Eddym06/AutoNex/simulator/README.md

# Simulador WRO Future Engineers

> El modelo predeterminado se cambió a bicicleta para el nuevo chasis Ackermann.
> Las medidas ficticias elegidas se detallan en [PERFIL_PROVISIONAL.md](PERFIL_PROVISIONAL.md).
> La geometría y el encoder son provisionales, y el parqueo es experimental;
> las cifras y pruebas históricas descritas abajo corresponden al chasis anterior.
> Tras cualquier cambio en el C hay que reconstruir el WASM: la generación del
> HTML comprueba un manifiesto de hashes y rechaza uno ausente o antiguo, y
> `core.js` aborta si la ABI del binario no es la esperada.
> El binario incluido está reconstruido y el manifiesto verifica las fuentes.
> La entrada al cajón y la misión completa Ackermann siguen sin medición real.

Simula una ronda completa de la pista WRO 2024 con sensores realistas y **ejecuta el C real del firmware** (visión del S3 no incluida: la cámara virtual produce imágenes RGB565 que pasan por el mismo `vision.c`; el planificador y el controlador del P4 corren compilados a WebAssembly). No hay reimplementación en JavaScript de la lógica, y el robot **no ve la verdad del mundo**: solo lo que miden sus sensores simulados.

## Uso

```powershell
python simulator\build_simulator.py      # genera simulator\build\simulador.html (un solo archivo)
```

Abre `simulador.html` en el navegador después de reconstruir el WASM. La salida
del cajón y el parqueo Ackermann son experimentales y aún no están validados
con sensores ni mediante rondas completas. Controles:
**Simular / Reiniciar**, velocidad de reproducción, pista, sentido, semilla,
plano JSON, capas visibles, lados de paso y parámetros de controlador y sensores.

> La interfaz se probó con un DOM simulado (`test_ui_smoke.js`), **no visualmente en un navegador**. Si algo se ve mal, es lo primero que conviene revisar.

## Qué modela

- **Pista** (reglamento 2026): campo de 3 × 3 m, carril de 100 cm, paredes de 10 cm, bloques 5 × 5 × 10 cm en asientos de 5 × 5 cm (2 × 3 por recta, modelo `seatModel` parametrizable), **8 líneas naranja/azul de 2 cm en V** (una pareja por esquina, a 30° de los muros) y el cajón de parqueo (20 cm de ancho, 1,5 × el largo del robot, topes magenta de 20 × 2 × 10 cm) en la sección de arranque.
- **LiDAR D6**: barrido continuo a 10 Hz con 400 rayos, ruido, pérdida de retornos, zona ciega y máscara del propio chasis. El robot se mueve durante el barrido (el firmware lo corrige con deskew).
- **Cámara**: proyección por trazado de rayos con cámara inclinada, ruido, viñeteo, nivel de luz, desenfoque, latencia y errores de bits.
- **Giroscopio**: sesgo y deriva aleatoria.
- **Encoders** (uno por rueda): ver «Encoders, pose estimada y herramientas de medida».
- **Robot**: chasis de 22 × 14 cm con **dirección Ackermann** (servo con retardo, límite de 40° por lado — 16,7 cm de radio mínimo del eje trasero — y desvío de 0,8°), motor trasero con zona muerta y ganancia de velocidad 0,94 que el controlador no conoce. El modo diferencial de 17 × 13 (`differential17`) sigue disponible para los planos y las cifras históricas: gira en el sitio y desliza por la pared. Contra un obstáculo el chasis desliza por la cara con la que roza; los bloques se empujan.
- **Juez** (2026): 1 punto por sección y por vuelta, 10 por no mover bloques, 3 por parar en la sección de arranque, 7 por arrancar en el cajón y completar una vuelta, 15 por aparcar dentro y en paralelo (la diferencia entre distancias de dos ruedas del mismo lado a la pared no supera 2 cm) o 7 si es parcial; tocar un tope termina la ronda; lado equivocado o bloque fuera de su círculo, también. Un robot que **gira en el sitio** no cuenta como parado (las maniobras de parqueo pivotan con velocidad 0). Máximo 62 puntos.

## Cajón, pose de arranque y perfil de robot

El reglamento ata el largo del cajón al del robot (1,5 ×) y la pose de arranque
centra el **cuerpo**, no el eje. Por eso la simulación ajusta los dos al chasis que
va a correr (`field.fitToRobot`): un plano que no fija `robotLength` se dibuja para
el robot simulado, y uno que sí lo fija se respeta tal cual (así el mismo JSON da
siempre la misma escena). Antes el cajón medía siempre 1,5 × 22 cm y la pose inicial
usaba el cuerpo de 22 cm: con el chasis de 17 cm el robot arrancaba con el morro
fuera del cajón y la maniobra de salida no tenía solución, así que el planificador se
quedaba parado y la ronda terminaba por `stalled`.

Un plano puede además declarar **para qué chasis se dibujó** con la clave `robot`
(`{"robot": "differential17"}`), y todos los que lo reproducen —la interfaz, el banco,
`depurar.py`, `layout.js`— corren ese perfil (`robot.js: PROFILES`) en vez del modelo
por defecto. Los dos planos de referencia del equipo son de ese chasis: reproducirlos
con el robot nuevo daba un cajón de 25,5 cm para un chasis de 22 cm y la maniobra de
salida no tenía solución. El controlador recibe además el largo real del cajón
(`park_lot_length_cm`), para no suponer que siempre mide 1,5 × su propio largo.

## Pruebas

```powershell
node simulator\tests\test_sim_basics.js     # geometría, sensores, dinámica, juez, avisos de plano
node simulator\tests\test_contrato.js       # ABI firmware↔simulación, frecuencia de cámara, cajón a medida
node simulator\tests\test_axle_encoder.js   # encoder de eje y reducción externa
node simulator\tests\test_parking_exit.js   # salida del cajón, 6 combinaciones sentido/semilla
node simulator\tests\test_parking_entry.js  # entrada al cajón: repasadas contadas y acotadas
node simulator\tests\test_ui_smoke.js       # la interfaz arranca
node simulator\tests\test_missions.js       # rondas completas (minutos)
python simulator\sequence_simulation.py     # secuencias de visión (129 comprobaciones) -> build\sequence-simulation\report.html
```

`Vision System\tools\simulate.ps1` ejecuta las pruebas en C y todas las de arriba
en orden (`-Quick` se salta las rondas completas).

Herramientas de depuración en `simulator/tests/` (`batch.js`, `scenario.js`, `inspect.js`, `planat.js`, `mapdump.js`…): ejecutan lotes de diseños aleatorios o muestran el mapa/plan en un instante dado.

## Recompilar el firmware a WebAssembly

El simulador carga `web/wro_core.wasm`, versionado en el repositorio. Si cambias el C de `LIDAR System/main`, `Vision System/main` o `shared/`, recompílalo:

```powershell
$env:WASI_SDK_PATH = "C:\ruta\wasi-sdk"   # o usa -Download para bajarlo a simulator\.toolchain
.\simulator\wasm\build.ps1                # o: Vision System\tools\simulate.ps1 -Wasm
```

`simulate.ps1` avisa si el `.wasm` es más antiguo que el C. La interfaz entre JS y C está en `wasm/core_api.c`.

## Resultados medidos

- Pista vacía, ambos sentidos: 3 vueltas, parada en el tramo de salida, 55 puntos, ~125–140 s.
- Con el chasis de 17 × 13 cm: salir del cajón, 3 vueltas y aparcar sin bloques, 62 puntos en los dos sentidos (`test_missions.js`), 24/24 secciones y sin contactos.
- Con el chasis Ackermann (volante a 40°): salir del cajón en **9,2–9,7 s**, 6 de 6 (`test_parking_exit.js`); aparcar desde la pista en 3 de 3; **misión completa de 62 puntos en 4 de 4 casos**, terminando a los 141–155 s de los 180, con 1 y con 2 letreros.
- El tiempo de las maniobras se fue en la velocidad, no en planificar: un perfil de la salida daba **21,9 s en movimiento y 0,4 s planeando**. Los arcos iban a 4 cm/s y, peor, **frenaban a ~1 cm/s en el último tramo de cada arco**, cuando el final de un arco no es una parada sino donde se encadena el siguiente. Quitado ese frenado y el tope de 4 cm/s, la salida pasó de 21–24 s a 9,2–9,7 s y la misión dejó de quedarse sin tiempo.
- 30° frente a 40°: con 40° las seis combinaciones de salida tardan 20,7–24 s; con 30° salían todas pero con un caso de 47–55 s. Más ángulo = salida más corta y más pareja.
- Banco de 100 pistas aleatorias con 7 letreros y cajón, a 23 cm/s: 99 perfectas (semillas 21–70) y 95 (semillas 71–120), sin contactos. `tests/plano_errores.json`: 62 puntos, 177 s. Estado y pendientes en `ESTADO.md` (raíz).
- Costo de un paso de simulación en el navegador con este WASM: 1,5 ms (unos 6,9 s simulados por segundo real). Ver `RENDIMIENTO.md`.

## Salir y entrar del cajón: la geometría que manda

Con la carrocería de 22 × 14 cm y el cajón de 20 × 33 cm (topes de 2 cm), el límite **no
es la pared de atrás** (con el cuerpo a 2 cm, la esquina trasera barre 8,06 cm alrededor
del eje, que está a 9 cm de la pared). El límite son **los topes de los extremos**: sólo
hay 5,5 cm de sobra por punta. Medido con el modelo de bicicleta y la maniobra "reversa
con el volante hacia el carril y luego avance al máximo":

| Volante | Reversa útil | Avance antes de tocar | Giro | ¿Sale en dos fases? |
| --- | ---: | ---: | ---: | --- |
| 30° | 4,3 cm | 9,3 cm | 32° | no: hay que hacer maniobra |
| 40° | 3,0 cm | 22,5 cm | 87° | sí |
| 45° | 2,3 cm | 22,5 cm | 101° | sí |

Con 40° la salida cabe en dos arcos, y eso es lo que hace el planificador
(`park_ackermann.c`): búsqueda A* sobre (u, w, θ) con arcos de 3,5 cm, avance y reversa,
colisión de las cuatro esquinas contra la pared y los dos topes, y re-localización en cada
barrido. Dos detalles que costaron encontrar: si la maniobra deja el chasis dentro del
margen de seguridad se reintenta **sin holgura** (si no, el planificador se niega a
planificar y el robot se queda parado el resto de la ronda), y la meta de salida exige
|θ| ≤ 10° para poder entrar al carril.

**Entrar es más caro que salir, y la asimetría está en la ejecución.** La simetría está bien
planteada — un camino libre recorrido al revés también es libre, porque son las mismas poses — y
el planificador aislado la cumple: desde la pose donde acaba la salida, la entrada cuesta **1
repasada**, igual que la salida. Por eso la entrada del controlador **arranca donde acabó la
salida** (`park_step` la recuerda al terminar `PARK_EXIT`): un crucero por el carril hasta 2 cm
más adelante y 1,5 cm más lejos de la pared (donde la maniobra cabe con una repasada, medido en
el planificador), y desde ahí **un solo plan** del A*.

Lo que quedaba era el **ejecutor**: el servo tarda ~0,2 s en invertir el volante, así que el
primer arco de cada cambio de sentido gira menos que el modelo, y los arcos medidos por distancia
se cortan 0,2–0,3 cm pronto. Sobre 15 arcos son ~3 cm y ~10° de morro; el planificador abortaba
el plan antes de enderezar y la corrección costaba una repasada más. Para la entrada simétrica los
arcos se cortan **por rumbo del giroscopio** (el giro exacto del plan), se vigila el avance a
ciegas (desvío > 6 cm o > 25° = algo pasó) y la comprobación del arco se hace con media holgura.
La salida y la demostración desde la pista se quedan con el ejecutor de siempre (la salida va
sobrada y así sigue en 8-9 s).

Medido en ronda completa (largo26, 4 casos):

| Entrada | Repasadas | Tiempo | Puntos |
| --- | --- | --- | --- |
| arrancar donde el LiDAR ve el cajón | 8, 4, 4, 3 | 12–17 s | 62 |
| simétrica desde la salida | **3, 3, 5, 6** | 13,7–17,5 s | 62 |

Todo *full* y sin contactos en los ocho casos. Probar más fuerte (sin holgura al comprobar el
arco) daba 2 repasadas en un caso pero el juez lo veía **parqueo parcial**: la media holgura es
el punto. Queda bajar el 5–6 de los casos "cw": el A* cambia de 1 a 2 repasadas con 1 cm de
diferencia en la pose de arranque (es su sensibilidad, no un error de cuenta); se mide con
`simulator/tests/parkentry.js`.

Para la entrada hay una **maniobra dedicada de tres tramos** (`park_ackermann_entry_maneuver`):
*colocarse con un arco de avance → entrar girando con un arco largo de reversa → enderezar*.
Se buscan las tres longitudes con la geometría real y solo se acepta si termina centrada y
paralela; el plan sale con **2 cambios de sentido** (medido, p. ej. `AAAA…RRRR…A`). Se
intenta en cada repaso mientras el coche siga en el carril; desde dentro del cajón manda el
A* (intentarla ahí no converge: la ronda acababa a los 180 s con parqueo parcial).

Aun así, **las repasadas ejecutadas son 4–8** (antes 7–8): las que quedan son la alineación
final dentro del cajón, donde el coche ya no puede hacer arcos largos y el A* trabaja con
arcos de 3,5 cm. La primera intentona con una S de dos arcos
(`park_ackermann_entry_s`) no cabe en este cajón: retroceder a volante lleno desde el carril
engancha la esquina trasera con el tope a los 6,5 cm.

## Depurar un plano: `tools/depurar.py`

```powershell
python simulator\tools\depurar.py plano.json                 # ronda estricta: se detiene en la primera infracción
python simulator\tools\depurar.py plano.json --indulgente    # anota todas las infracciones y sigue, para ver todos los fallos
python simulator\tools\depurar.py plano.json --permitir parqueo   # da por bueno un hallazgo ya documentado (se sigue imprimiendo)
python simulator\tools\depurar.py plano.json --json info.json --ctrl "planner.speed_cm_s 15"
```

Ejecuta el plano en **el mismo simulador** (firmware C en WebAssembly, sensores, robot, juez; con el cuadro de configuración por defecto como la interfaz, y el chasis que declare el plano) y escribe un informe: resultado, fases, y para cada hallazgo (infracciones, paradas, bucles de reversa, contactos, tramos lentos, salida/parqueo que no terminan, avisos del plano) el instante, la posición, la sección, lo que decide el firmware, los letreros reales cerca y el **mapa del planificador** en ese instante, con el comando exacto para mirarlo más (`tools/debug_trace.js snap plano.json T`). Pensado para que cualquier persona o modelo localice el problema sin leer trazas enormes. Devuelve código de salida 1 si encuentra infracciones, paradas, bucles, o una salida del cajón o un parqueo que no terminan (`--permitir <tipo>` los degrada a avisos, para un caso ya documentado).

Los **avisos del plano** (`field.checkLayout`, también visibles en la interfaz bajo el panel del juez) detectan letreros consecutivos —o la salida del cajón y un letrero— que exigen cambiar de lado más rápido de lo que cabe: es un problema del plano, no del firmware. Casos de ejemplo: `tests/plano_errores.json` (tiene dos) y `tests/plano_corregido.json` (sin avisos; ronda completa sin hallazgos, parqueo incluido).

## Reproducir un caso

Desde la interfaz, **Plano ⇄ JSON** exporta el diseño. Para ejecutarlo sin navegador y ver qué decide el robot:

```powershell
node simulator\tests\layout.js plano.json                 # ronda completa y veredicto del juez
node simulator\tests\layout.js plano.json 20 40 1         # traza del segundo 20 al 40
node simulator\tests\ctrltrace.js plano.json 10 30 1      # rumbo del giroscopio, rumbo del recorrido, paredes, esquinas
node simulator\tests\dumpat.js plano.json 26 45           # mapa local del planificador en ese instante
```

`simulator/tests/plano_atasco.json` es un caso real reportado (se quedaba yendo y viniendo): la causa era que, tras esquivar pegado a la pared, el rumbo del recorrido se reanclaba con las paredes vistas en diagonal y la esquina no se contaba. Está corregido; ver *Limitaciones físicas* abajo para lo que queda de ese plano.

## Linea de carrera

Con `race_enabled 1` (apagada por defecto) el robot calcula tras la primera vuelta una linea de carrera: el mapa la dibuja coloreada por la velocidad que pide (casilla *linea de carrera*) y el panel *Controlador* tiene una fila con su estado. `node simulator/tools/race_check.js SEMILLA ccw|cw [--cfg ..] [--trace --lap 2]` muestra cuando se construye, que letreros conoce frente a los reales, y velocidad media por vuelta. El banco de 100 pistas (`tools/bench/big.sh`) admite `WEB=carpeta` (copia congelada de `simulator/web`), `OUT=carpeta`, `FROM`/`TO` y `SIGNS`.

## Cómo es la pista y qué se ve

- **Pista**: es la del reglamento WRO Future Engineers 2024 (campo de 3 × 3 m, paredes negras de 10 cm, carril de 100 cm con el cuadrado interior de 100 × 100 cm). Las medidas salen del reglamento oficial; las posiciones de los letreros no (ver abajo).
- **Líneas naranja y azul**: son las líneas del suelo de las cuatro esquinas (2 naranjas y 2 azules, 20 mm de ancho) que el reglamento pinta cruzando el carril. Sirven al robot para contar esquinas y vueltas sin odometría y, según el orden en que las cruza, para saber el sentido. La cámara del S3 ya envía la fila donde las ve; el controlador aún no las usa (cuenta esquinas con el LiDAR y el giroscopio).
- **Circulitos grises**: son los **asientos de letrero**: en la pista real cada letrero se coloca dentro de un círculo impreso de 85 mm; si el robot lo saca de ese círculo, termina la ronda. Haz clic en uno para alternar rojo / verde / vacío. **Las posiciones de los círculos son una suposición mía** (a 0,4 y 0,8 de cada recta y a −20 %, 0 y +20 % del ancho del carril): hay que medirlas en tu pista (`seatModel`).
- **Punto celeste**: posición del LiDAR en el chasis.

## Limitaciones físicas de los diseños

(Texto histórico del modo con servo; el chasis actual es diferencial de 17 × 13 cm y puede girar en el sitio.) En el modo con servo, el giro mínimo es de ~21 cm de radio (batalla 12 cm, volante 30°). Dos letreros seguidos que exigen cambiar de lado más rápido de lo que ese radio permite no tienen trayectoria hacia delante: por ejemplo, verde en el borde exterior y rojo en el centro 40 cm después, recorridos en el sentido contrario (necesita 36 cm de desplazamiento en ~23 cm de recta; un giro en S de este radio pide ≥ 41 cm). Con el recorrido en el sentido original sí cabe. Si la tercera vuelta se conduce al revés, ese par se queda sin paso. El generador aleatorio descarta ahora esos pares en **ambos** sentidos; un plano dibujado a mano puede contenerlos, y el robot se queda alternando reversa y avance hasta agotar el tiempo (o termina por `stuck_relax_s`, si se activa, con una infracción de lado).

## Qué NO está validado

- **Posición de los asientos de bloques**: el reglamento da el rango; el simulador usa un modelo parametrizable. Mídelo en tu pista y ajústalo.
- Montaje real de cámara y LiDAR (altura, inclinación, adelanto), ganancia de velocidad, recorte del volante: son valores de partida.
- El ruido del LiDAR es acotado y reproducible, no la distribución real del D6; el modelo no incluye reflejos ni pérdidas de paquetes UART.
- No hay ultrasónicos ni ToF en el modelo.

## Encoders, pose estimada y herramientas de medida

El simulador modela los encoders de las ruedas: cada rueda tiene su diámetro real (±1,5 % respecto al nominal que cree el firmware), patina a ráfagas y gira poco contra un obstáculo; el sensor entrega grados enteros a 50 Hz con 15 ms de retardo y pierde alguna muestra (`encoder` en las opciones: `resolutionDeg`, `hz`, `latencyMs`, `dropRate`, `diameterErrorPct`). Usan generadores aleatorios propios, así que no alteran las secuencias del LiDAR, la cámara ni el giroscopio.

En la interfaz, el panel *Controlador* muestra la **odometría** (camino, velocidad, patinajes, error frente a la verdad) y la **pose en el campo** del localizador (con su error), y el mapa dibuja la pose estimada: contorno amarillo = odometría corregida con el LiDAR, cruz magenta = solo encoders y giroscopio (casilla *pose estimada*). El error se calcula con la verdad del simulador; en el robot real no existe.

Por línea de comandos:

```powershell
node simulator\tools\odom_check.js 100 3        # error de la odometria sola (segundos, semilla)
node simulator\tools\arena_check.js 100 3       # error de la pose del localizador del campo
```

## Motor físico y MIC en el simulador

Con la opción `mic: true` (`new Simulation(core, { ..., mic: true })`, o `MIC=1` en `tests/parkentry.js`) el chasis Ackermann deja de seguir la velocidad ordenada con un primer
orden y usa un **motor físico del JGB37-520** (R, Ke, masa, fricción, caída del L298N, encoder cuantizado de 0,047 cm; parámetros *distintos* de los que MIC supone)
gobernado por MIC, que se ejecuta a 1 kHz dentro de cada paso de física (`robot.enableMotor`, `core.micUpdate`). `park_exact_moves 1` (con `EXACT=1` en `parkentry.js`) hace que cada
arco recto se pida como avance exacto (`move_cm`); hoy empeora el parqueo (ver `PENDIENTES_PARQUEO.md`) y está apagado.

## Mapa persistente (trace_map)

`core.traceObjects()` (letreros y topes con id, tipo, color, posición, tamaño), `core.traceSpot()` (plaza de parqueo) y `core.traceMap()` (rejilla, espacio libre `miss`, celdas borradas).
Se mide contra la verdad con `node simulator/tools/measure_trace_objects.js [semillas] [segundos] [letreros]`; la prueba es `tests/test_trace_map.js`. Ver `TRACE_MAP.md`.

## Medir el parqueo

```powershell
node simulator\tests\parkentry.js largo26 ronda 180 4        # 8 rondas (4 semillas x 2 sentidos)
node simulator\tests\parkentry.js largo26 entrada 90 4       # arranque en la pista, sin salida previa
$env:DIR='cw'; $env:SEED='4'; node simulator\tests\parkentry.js largo26 ronda 180 1   # una ronda
$env:MIC='1'; node simulator\tests\parkentry.js largo26 ronda 180 4                   # con el motor físico y MIC
```

Valida siempre con semillas nuevas (21 en adelante): las 1-8 están sobreajustadas. Recompilar el WASM tras tocar el C: `bash simulator/tools/bench/rebuild_wasm.sh` o `simulator\wasm\build.ps1`.
## Cómo se genera `build/simulador.html`

`simulator/build_simulator.py` toma `web/index.template.html`, mete dentro (en línea) todos los `.js` de `web/` y el firmware `wro_core.wasm` en base64, y escribe **un solo archivo** `build/simulador.html` que funciona sin servidor ni red. Sobrescribe el anterior cada vez. Pone en el título una marca de compilación (`fecha · fw hash`); el hash es el del `.wasm`, así que cambia solo si cambia el firmware. `Vision System/tools/simulate.ps1` lo ejecuta como último paso (después de pasar todas las pruebas); también puede lanzarse a mano con `python simulator\build_simulator.py`.

El `.wasm` en sí **no** lo genera ese paso: se compila con `simulator\wasm\build.ps1` (o `simulate.ps1 -Wasm`) a partir del C de `LIDAR System/main` y `Vision System/main`. Cambiar el firmware exige recompilar el wasm y después regenerar el html.
# Estado de la adaptación

El perfil activo es Ackermann con tracción trasera y encoder de eje, con medidas
provisionales. El texto histórico inferior incluye ejemplos y resultados del
carrito diferencial anterior. La salida del cajón se probó aisladamente; la
entrada y la carrera completas aún no están validadas. La salida diferencial
histórica no funciona con la configuración actual. Las colisiones y el empuje
son aproximaciones, no un modelo físico calibrado.

La interfaz genera pistas con un filtro geométrico conservador: puede colocar
menos letreros de los solicitados y no garantiza que exista una trayectoria.
