Eddym06/AutoNex/docs/photos/front.jpg

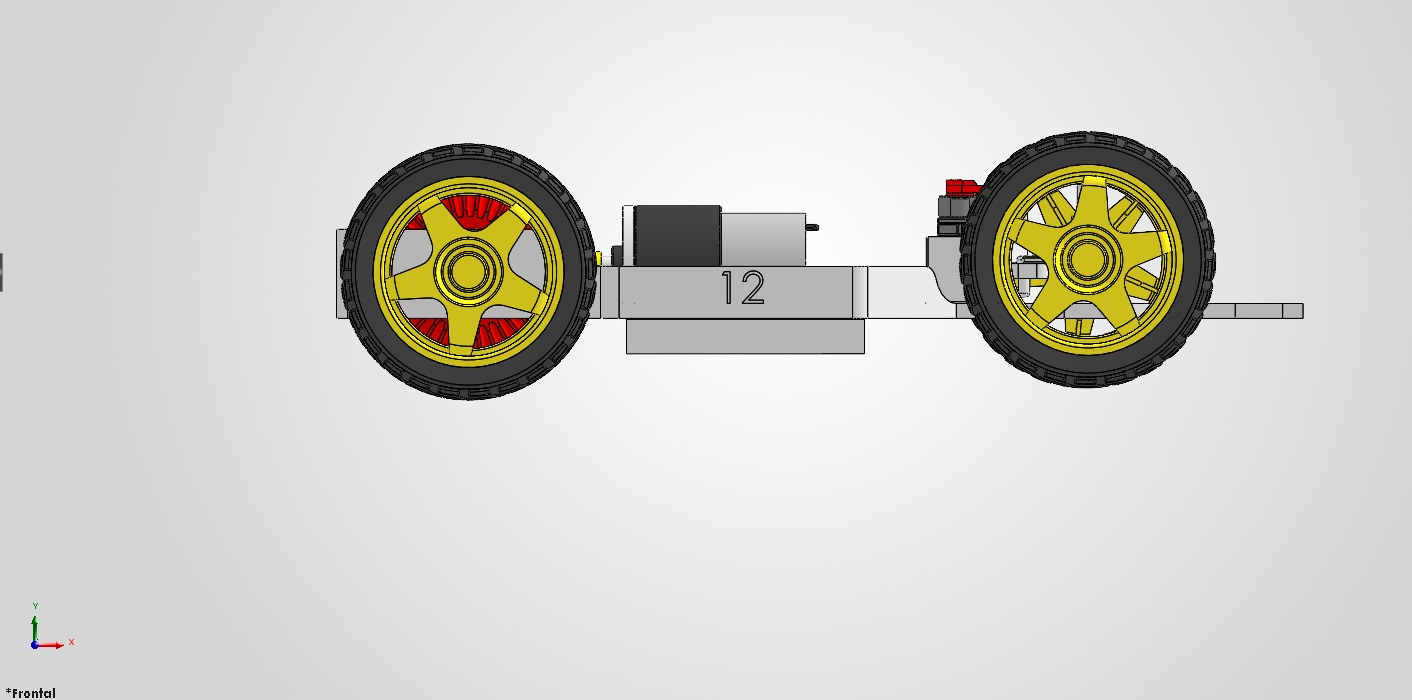
docs/photos/front.jpg
