Eddym06/AutoNex/docs/photos/left.jpg

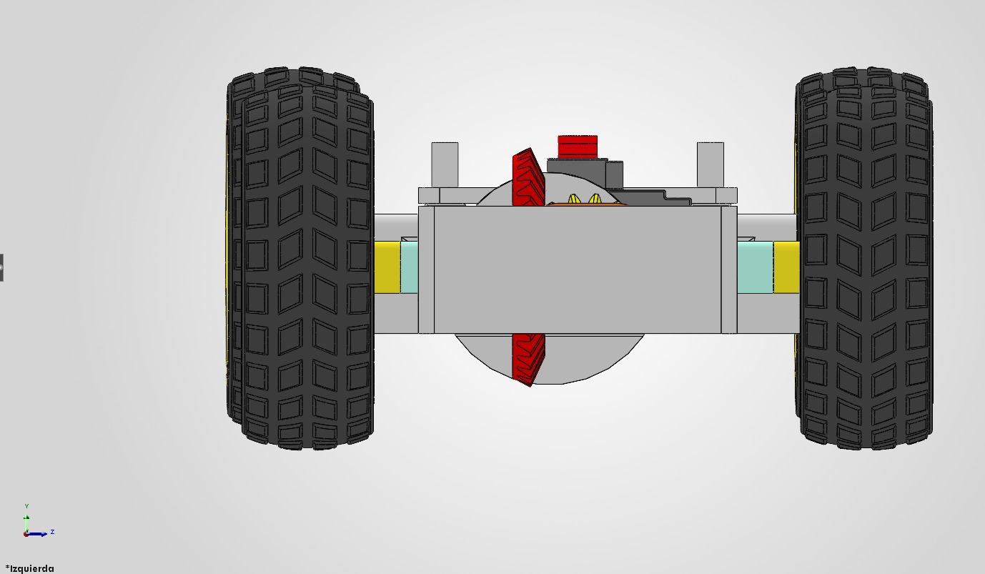
docs/photos/left.jpg
