Eddym06/AutoNex/docs/photos/rear.jpg

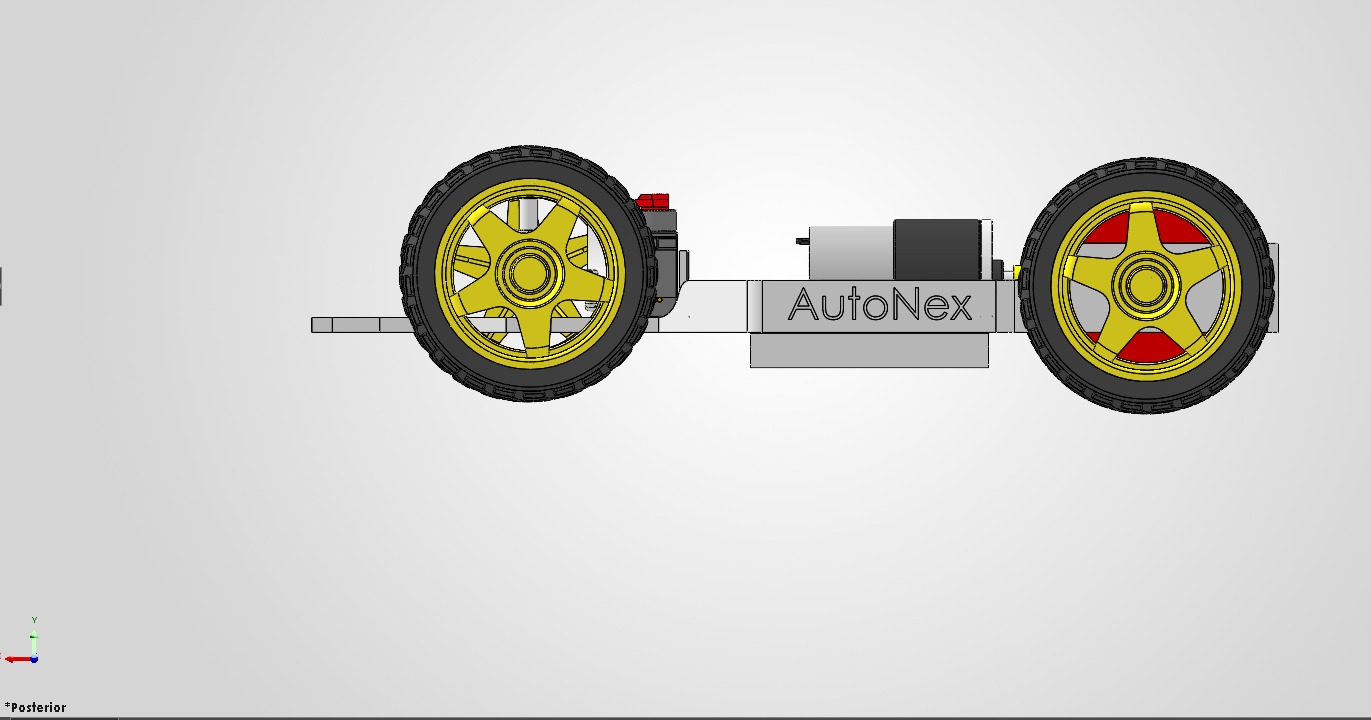
docs/photos/rear.jpg
