Eddym06/AutoNex/docs/photos/right.jpg

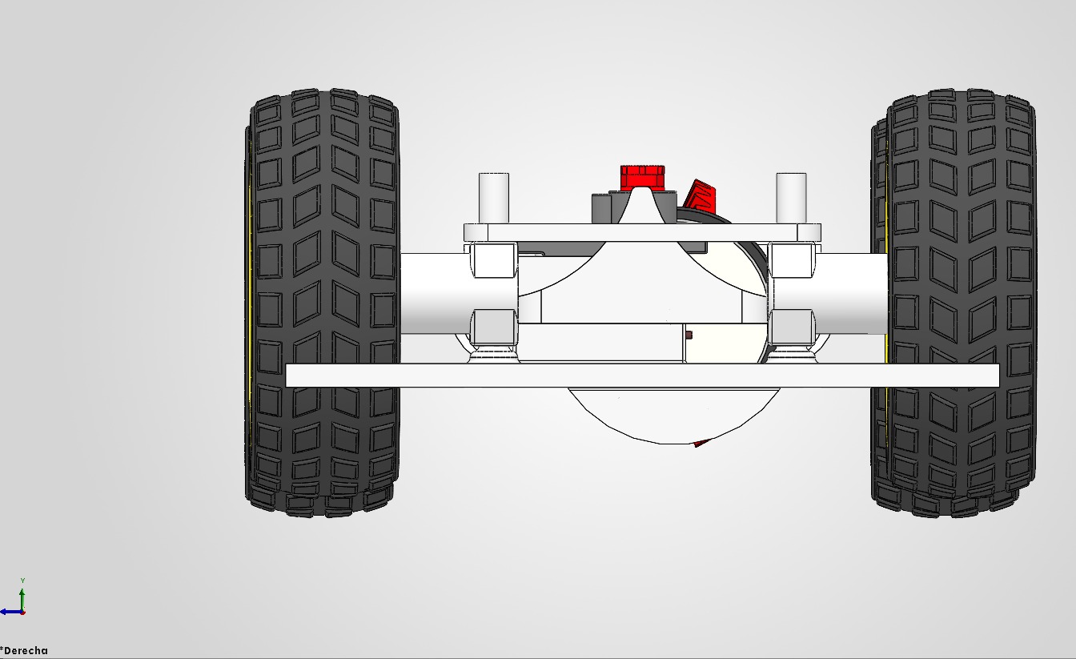
docs/photos/right.jpg
