Eddym06/AutoNex/docs/photos/team.jpg

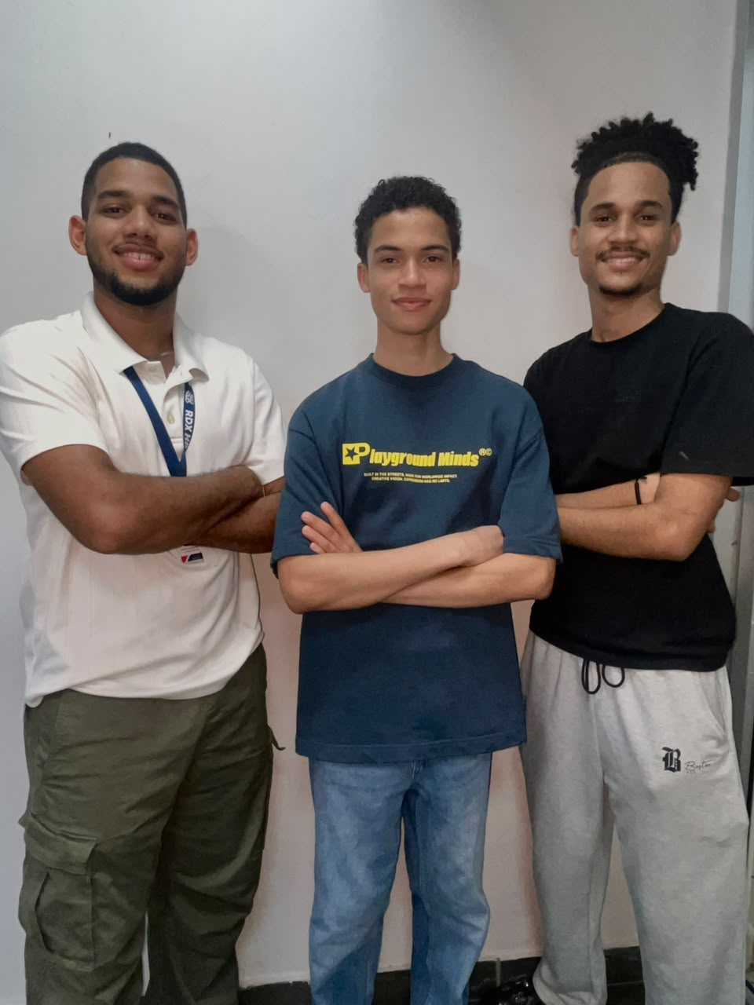
docs/photos/team.jpg
