Eddym06/AutoNex/CAD_File/Dc motor/Assembly dc motor.SLDASM

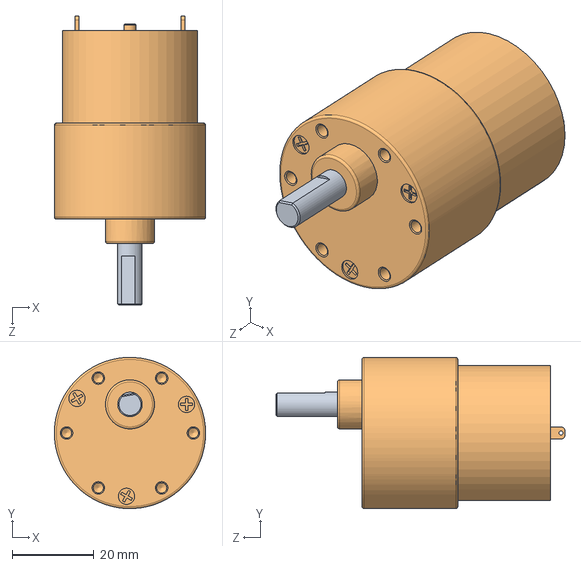
[picture p14: CAD file, 2026-11-14]
CAD_File/Dc motor/Assembly dc motor.SLDASM
37.0 x 37.0 x 70.7 mm
Dc motor
Axis of dc motor
