Eddym06/AutoNex/CAD_File/Diferencial/assambly of diferencial.SLDASM

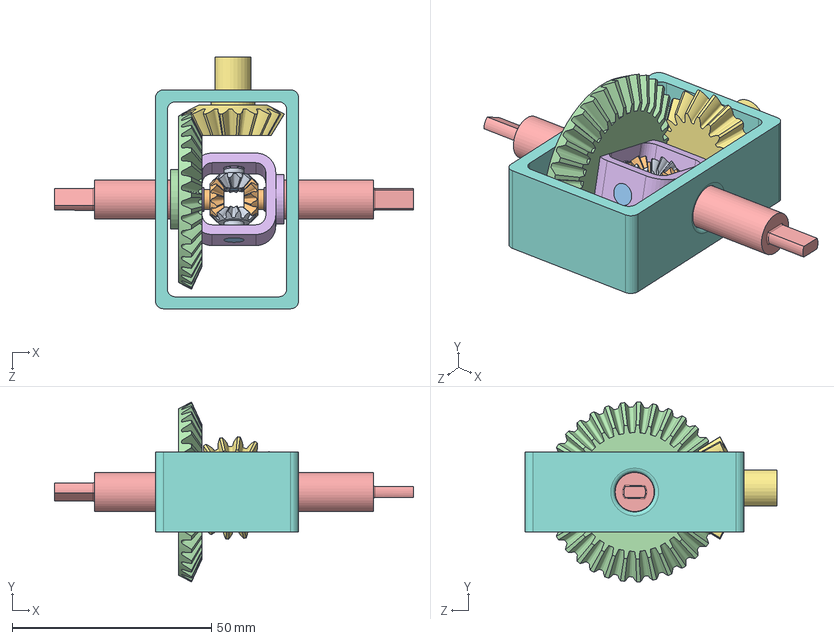
[picture p15: CAD file, 2026-11-14]
CAD_File/Diferencial/assambly of diferencial.SLDASM
90.2 x 45.2 x 63.2 mm
Base
gear3
Base of gear
Axis of wheel x 2
gear 4
Axis of gear 2 x 2
gear1 x 2
gear2 x 2
