Eddym06/AutoNex/CAD_File/Main part/Car assembly.SLDASM

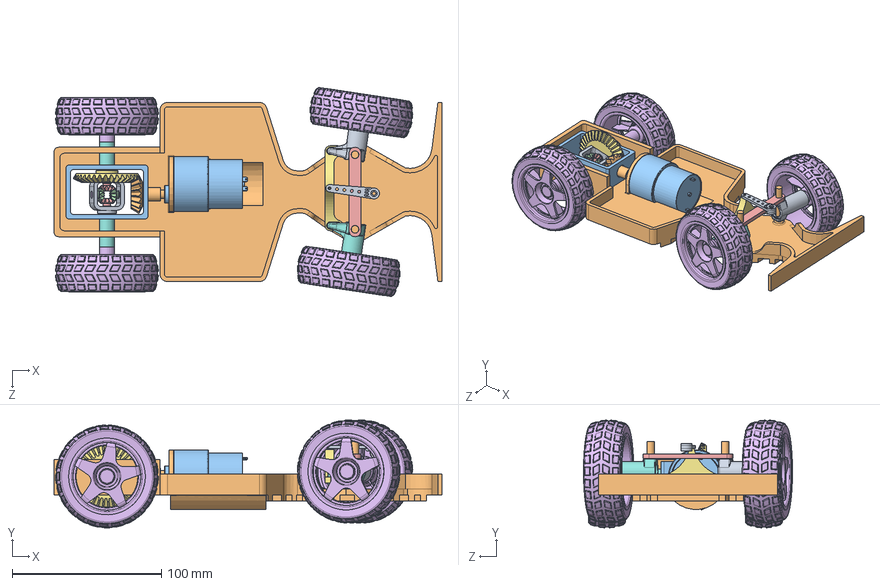
[picture p16: CAD file, 2026-11-14]
CAD_File/Main part/Car assembly.SLDASM
260.0 x 72.2 x 140.1 mm
Chassis
wheel holder 1
wheel holder 2
direction
Wheel D65x25 x 4
wheel dirctor - lock
bearing x 2
Base
gear3
Base of gear
Axis of wheel x 2
gear 4
Axis of gear 2 x 2
gear1 x 2
gear2 x 2
Dc motor
Axis of dc motor
Servo Arm
