Eddym06/AutoNex/CAD_File/Dc motor/Dc motor.SLDPRT

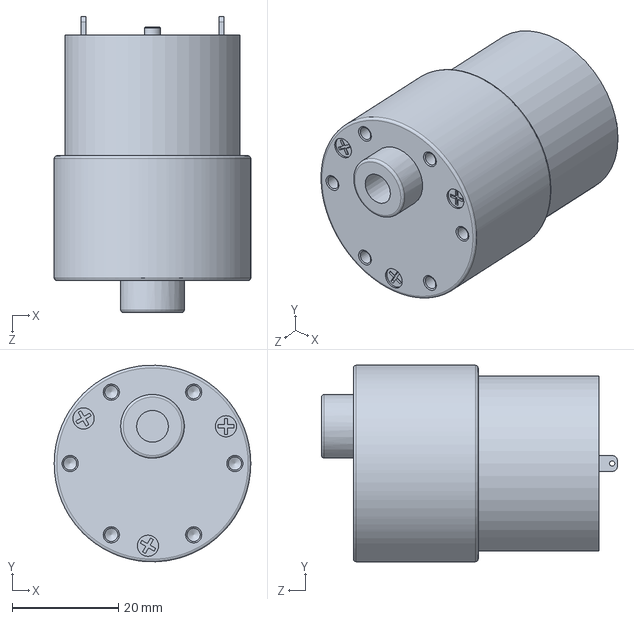
[picture p17: CAD file, 2026-11-14]
CAD_File/Dc motor/Dc motor.SLDPRT
37.0 x 37.0 x 55.7 mm
