Eddym06/AutoNex/CAD_File/Diferencial/gear 4.SLDPRT

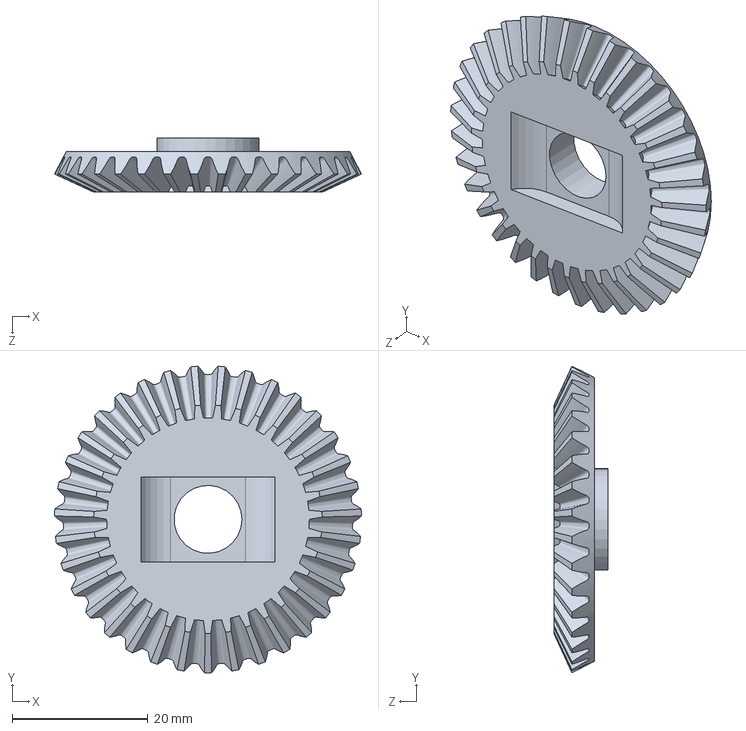
[picture p18: CAD file, 2026-11-14]
CAD_File/Diferencial/gear 4.SLDPRT
45.2 x 45.2 x 8.00 mm
