Eddym06/AutoNex/CAD_File/Main part/wheel holder 2.SLDPRT

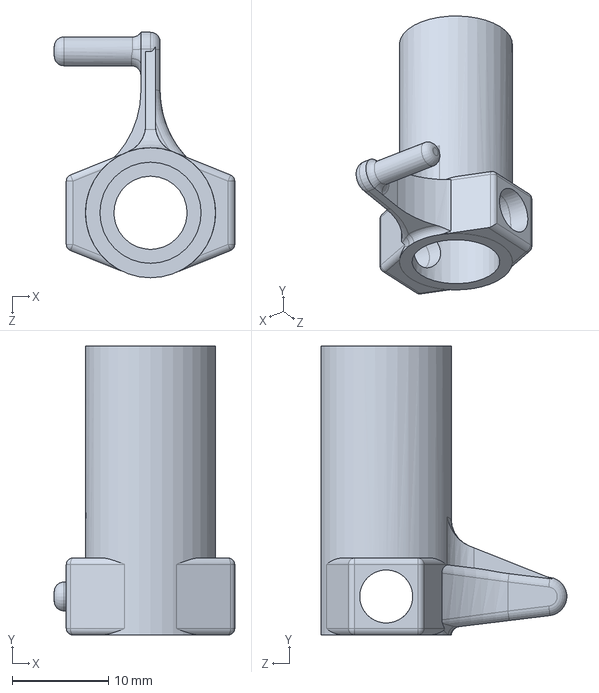
[picture p19: CAD file, 2026-11-14]
CAD_File/Main part/wheel holder 2.SLDPRT
18.8 x 30.0 x 25.5 mm
