Eddym06/AutoNex/Motor Control/design 3d/DiscoEncoder_30ranuras.step

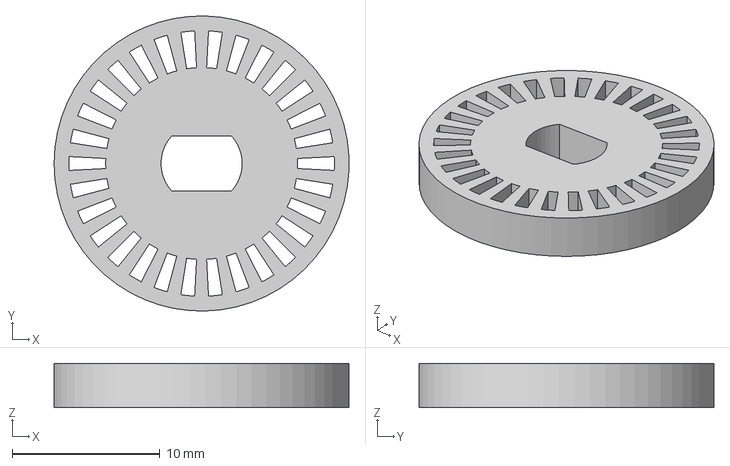
[picture p20: CAD file, 2026-11-07]
Motor Control/design 3d/DiscoEncoder_30ranuras.step
20.0 x 20.0 x 3.00 mm
