Eddym06/AutoNex/CAD_File/Diferencial/Axis of gear 2.SLDPRT

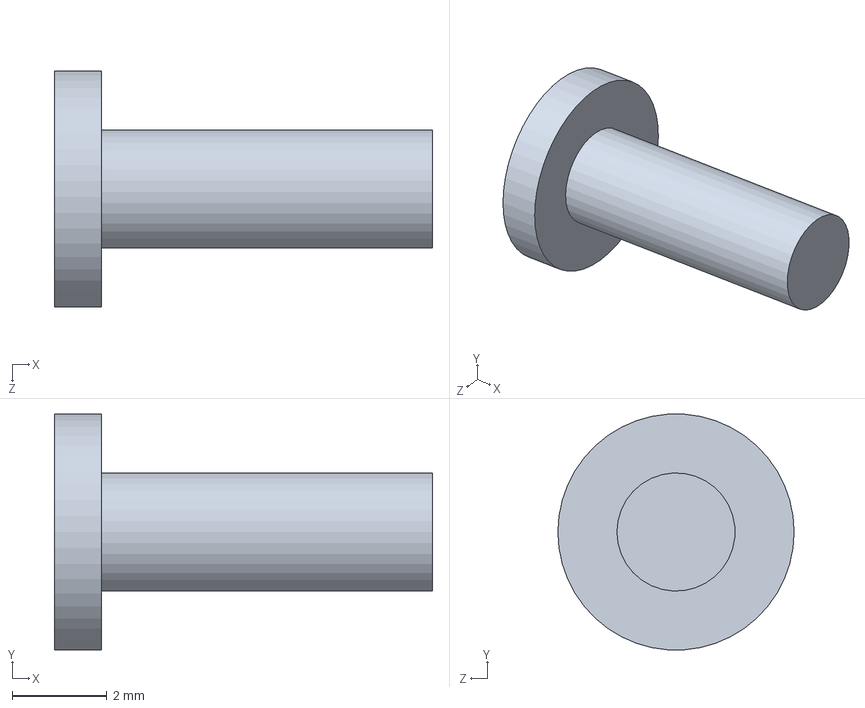
[picture p21: CAD file, 2026-11-14]
CAD_File/Diferencial/Axis of gear 2.SLDPRT
8.00 x 4.99 x 5.00 mm
