Eddym06/AutoNex/CAD_File/Main part/wheel holder 1.SLDPRT

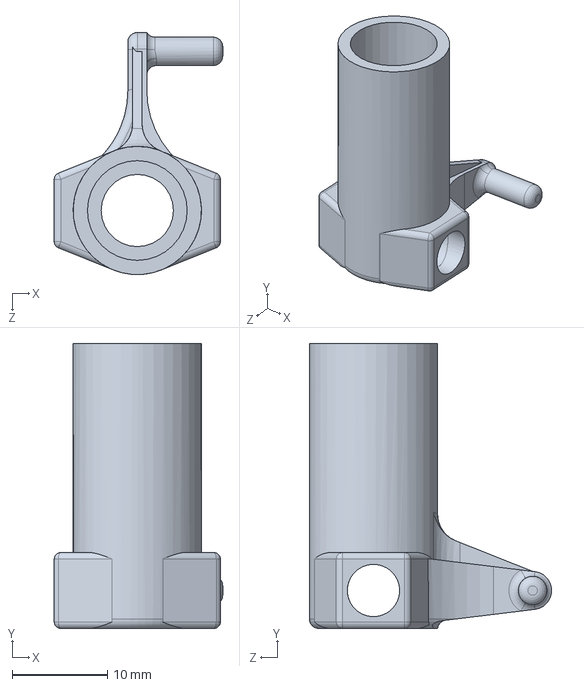
[picture p22: CAD file, 2026-11-14]
CAD_File/Main part/wheel holder 1.SLDPRT
17.8 x 30.0 x 25.5 mm
