Eddym06/AutoNex/CAD_File/Dc motor/Axis of dc motor.SLDPRT

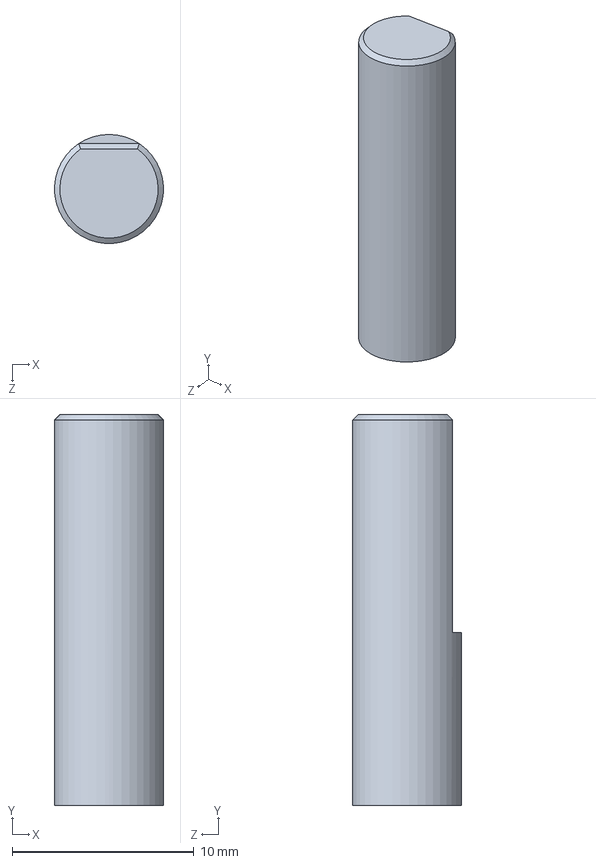
[picture p23: CAD file, 2026-11-14]
CAD_File/Dc motor/Axis of dc motor.SLDPRT
6.00 x 21.5 x 6.00 mm
