Eddym06/AutoNex/CAD_File/Electronic part/Batery.SLDPRT

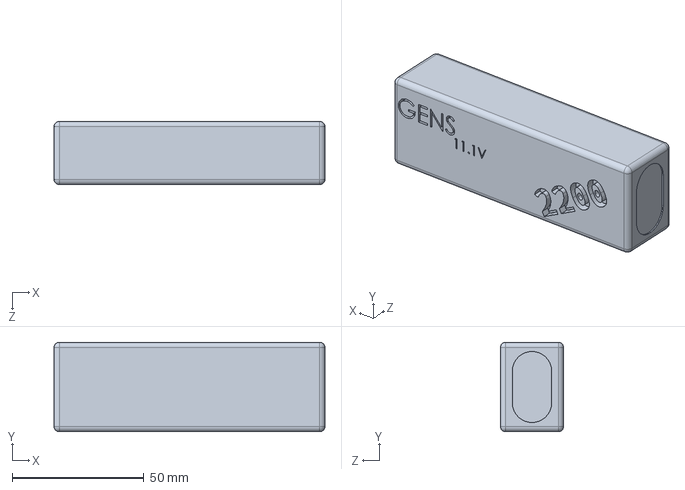
[picture p24: CAD file, 2026-11-14]
CAD_File/Electronic part/Batery.SLDPRT
103.0 x 34.0 x 24.0 mm
