Eddym06/AutoNex/CAD_File/Diferencial/gear2.SLDPRT

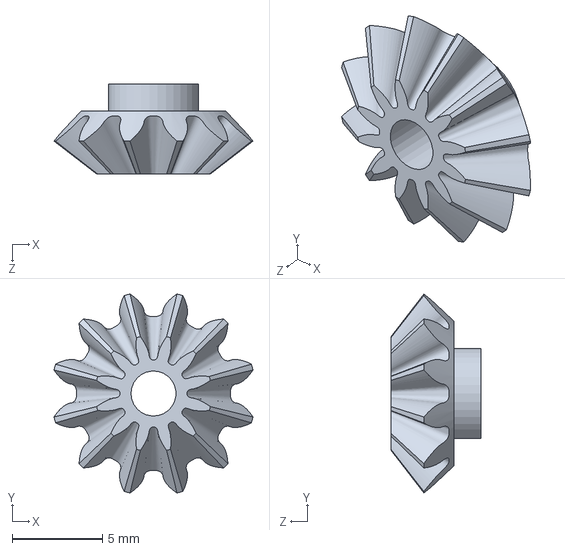
[picture p25: CAD file, 2026-11-14]
CAD_File/Diferencial/gear2.SLDPRT
11.1 x 11.1 x 5.00 mm
