Eddym06/AutoNex/CAD_File/Electronic part/Servo-MG90S.SLDPRT

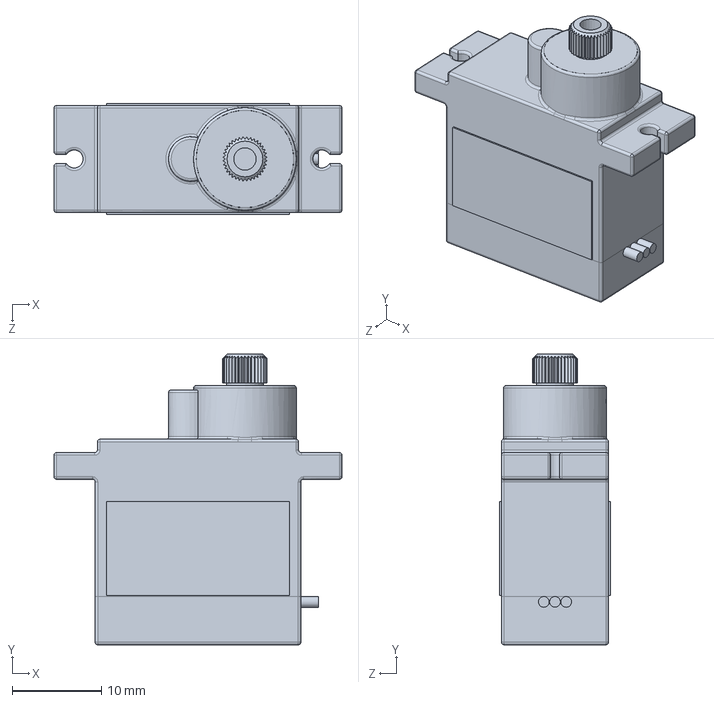
[picture p26: CAD file, 2026-11-14]
CAD_File/Electronic part/Servo-MG90S.SLDPRT
32.2 x 32.5 x 12.4 mm
