Eddym06/AutoNex/CAD_File/Diferencial/Base of gear.SLDPRT

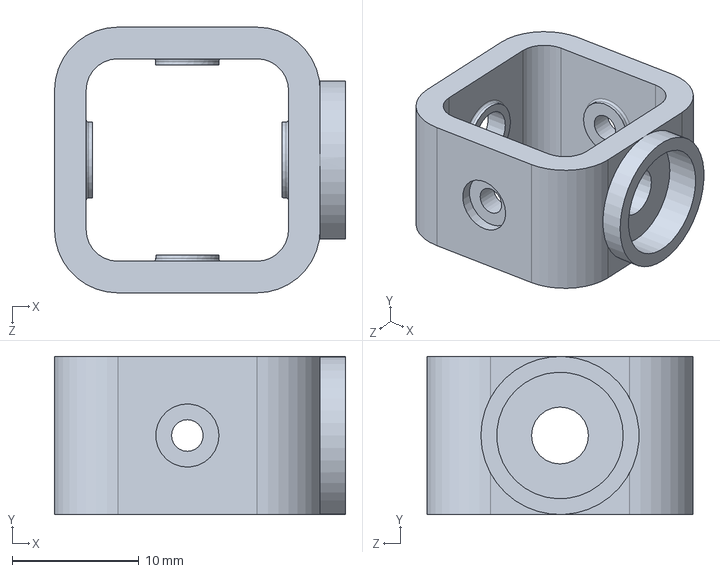
[picture p27: CAD file, 2026-11-14]
CAD_File/Diferencial/Base of gear.SLDPRT
23.0 x 12.5 x 21.0 mm
