Eddym06/AutoNex/CAD_File/Main part/Chassis.SLDPRT

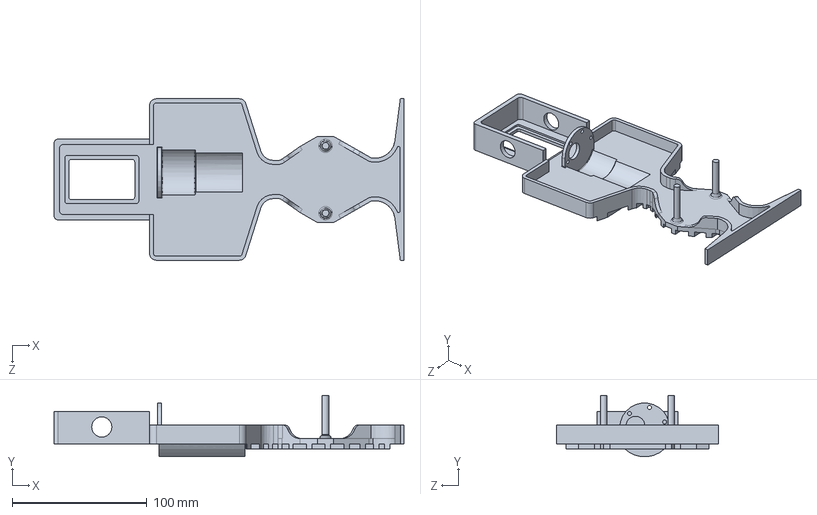
[picture p28: CAD file, 2026-11-14]
CAD_File/Main part/Chassis.SLDPRT
260.0 x 45.5 x 120.0 mm
