Eddym06/AutoNex/CAD_File/Diferencial/Axis of wheel.SLDPRT

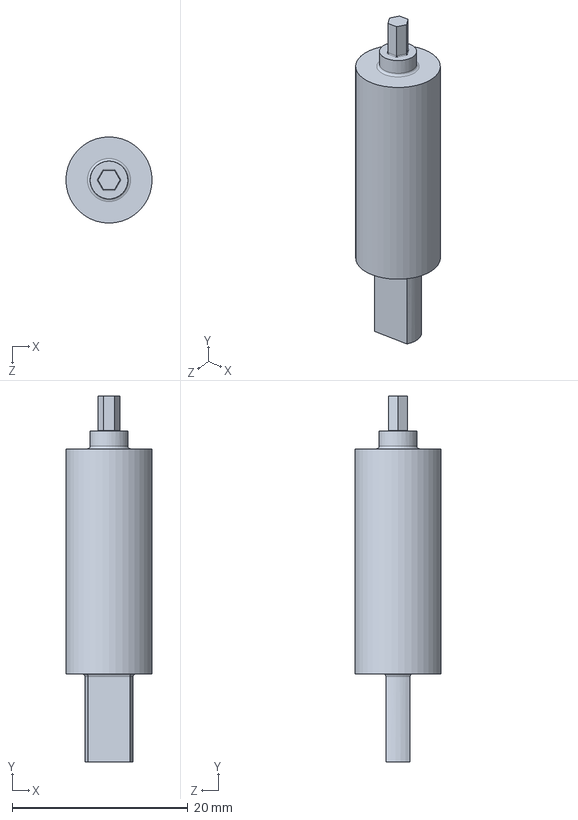
[picture p29: CAD file, 2026-11-14]
CAD_File/Diferencial/Axis of wheel.SLDPRT
9.80 x 41.6 x 9.80 mm
