Eddym06/AutoNex/CAD_File/Main part/Sure1.SLDPRT

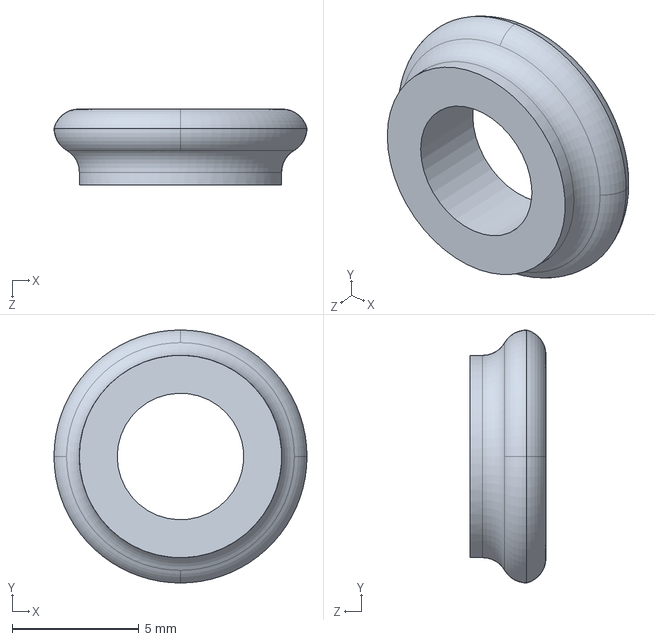
[picture p30: CAD file, 2026-11-14]
CAD_File/Main part/Sure1.SLDPRT
10.0 x 10.0 x 3.00 mm
