Eddym06/AutoNex/CAD_File/Diferencial/gear3.SLDPRT

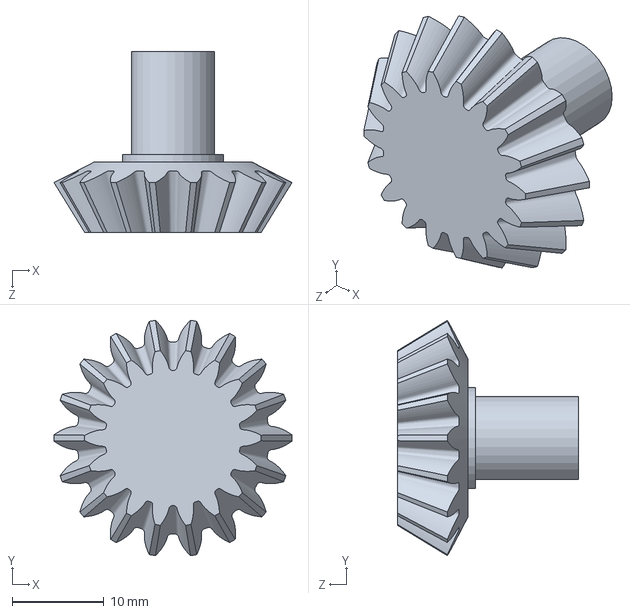
[picture p31: CAD file, 2026-11-14]
CAD_File/Diferencial/gear3.SLDPRT
25.9 x 25.6 x 19.7 mm
