Eddym06/AutoNex/CAD_File/Main part/Servo Arm.SLDPRT

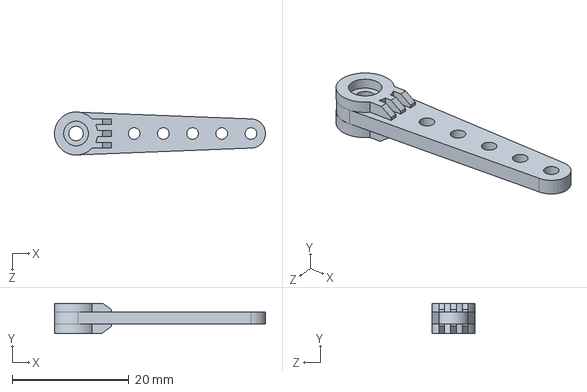
[picture p32: CAD file, 2026-11-14]
CAD_File/Main part/Servo Arm.SLDPRT
36.1 x 5.20 x 7.39 mm
