Eddym06/AutoNex/CAD_File/Diferencial/Base.SLDPRT

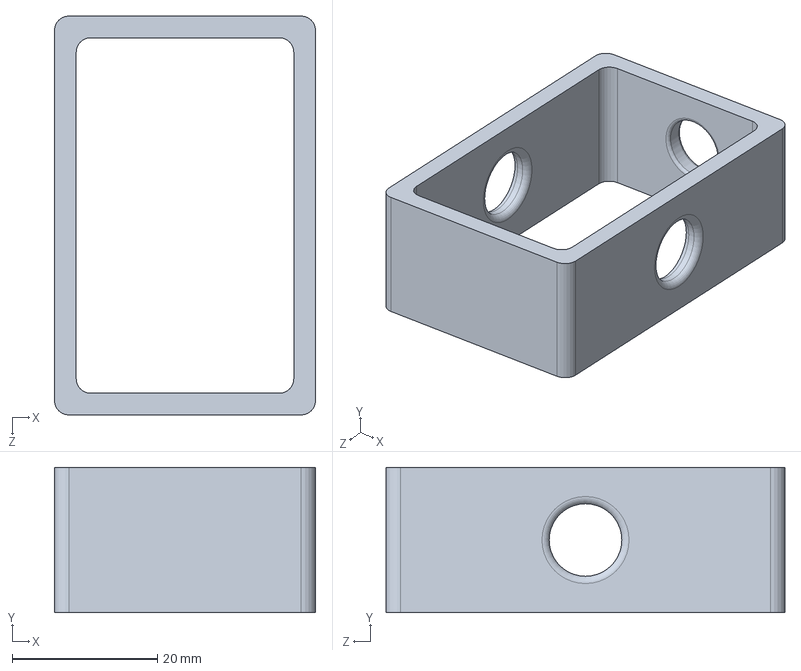
[picture p33: CAD file, 2026-11-14]
CAD_File/Diferencial/Base.SLDPRT
36.0 x 20.0 x 55.0 mm
