Eddym06/AutoNex/CAD_File/Main part/Bsae of lidar.SLDPRT

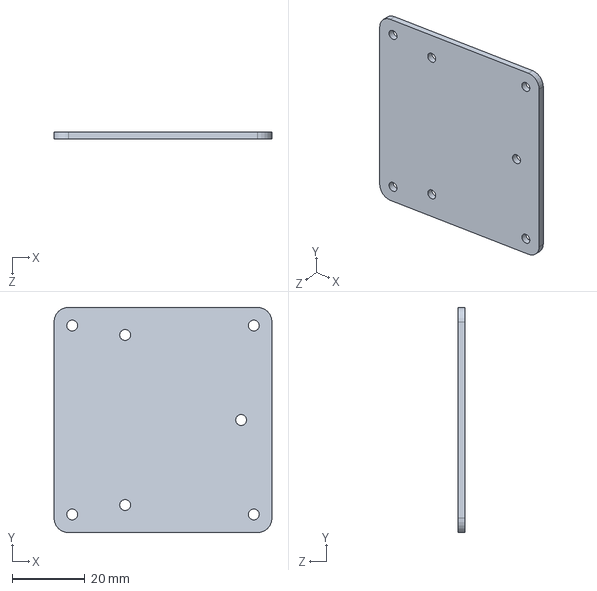
[picture p34: CAD file, 2026-11-14]
CAD_File/Main part/Bsae of lidar.SLDPRT
60.0 x 62.0 x 2.00 mm
