Eddym06/AutoNex/CAD_File/Main part/direction.SLDPRT

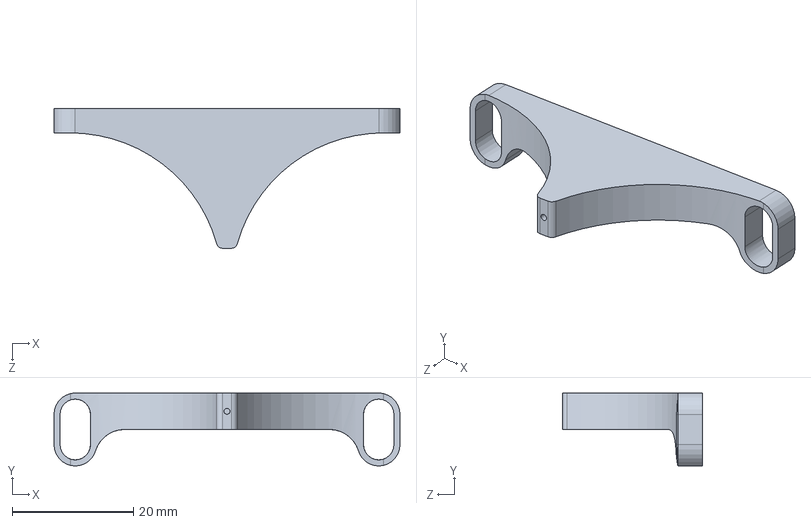
[picture p35: CAD file, 2026-11-14]
CAD_File/Main part/direction.SLDPRT
57.0 x 12.0 x 23.0 mm
