Eddym06/AutoNex/CAD_File/Main part/bearing.SLDPRT

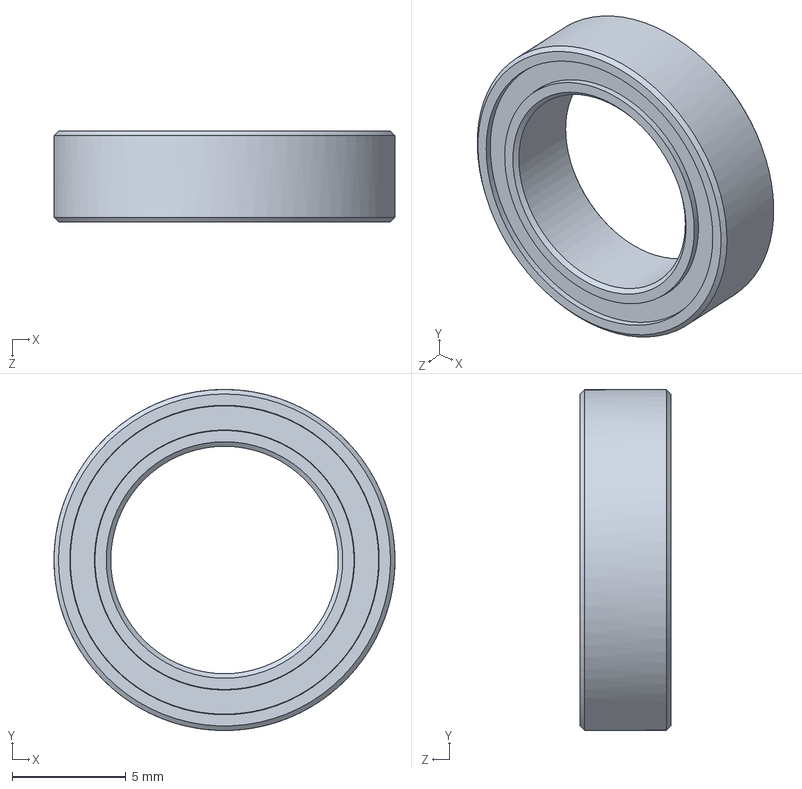
[picture p36: CAD file, 2026-11-14]
CAD_File/Main part/bearing.SLDPRT
15.0 x 15.0 x 4.00 mm
