Eddym06/AutoNex/CAD_File/Main part/Sure2.SLDPRT

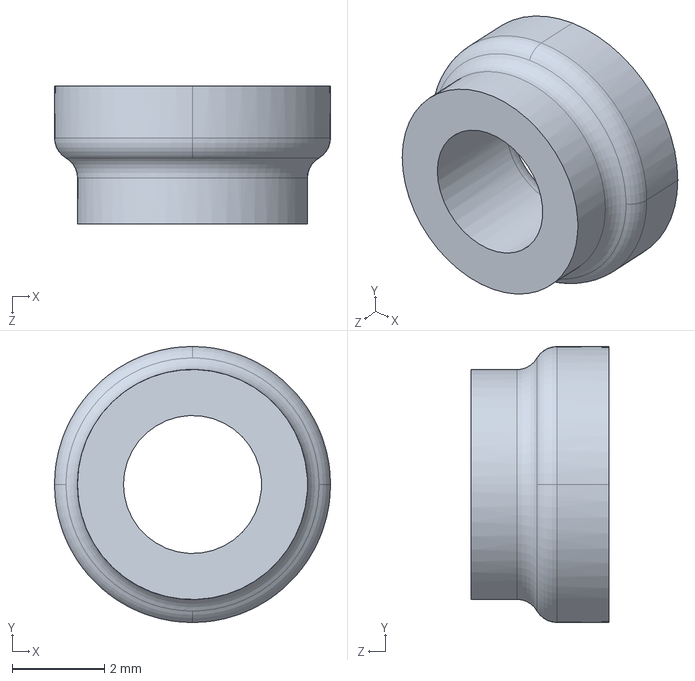
[picture p37: CAD file, 2026-11-14]
CAD_File/Main part/Sure2.SLDPRT
6.00 x 6.00 x 3.00 mm
