Eddym06/AutoNex/CAD_File/Main part/Wheel D65x25.SLDPRT

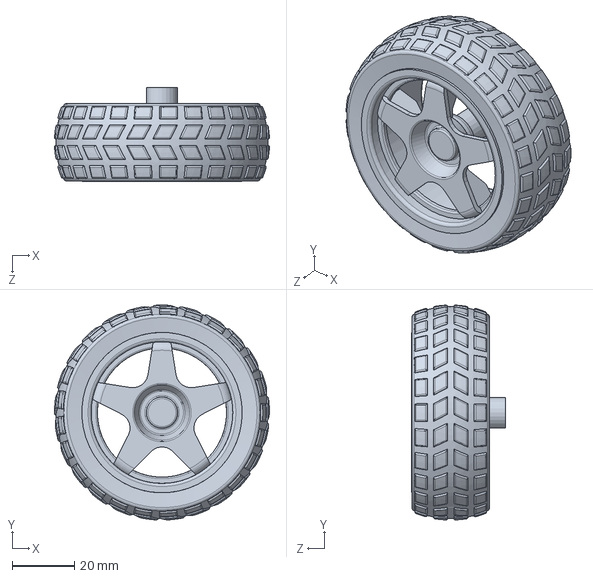
[picture p38: CAD file, 2026-11-14]
CAD_File/Main part/Wheel D65x25.SLDPRT
68.9 x 68.9 x 30.0 mm
