Eddym06/AutoNex/CAD_File/Main part/wheel dirctor - lock.SLDPRT

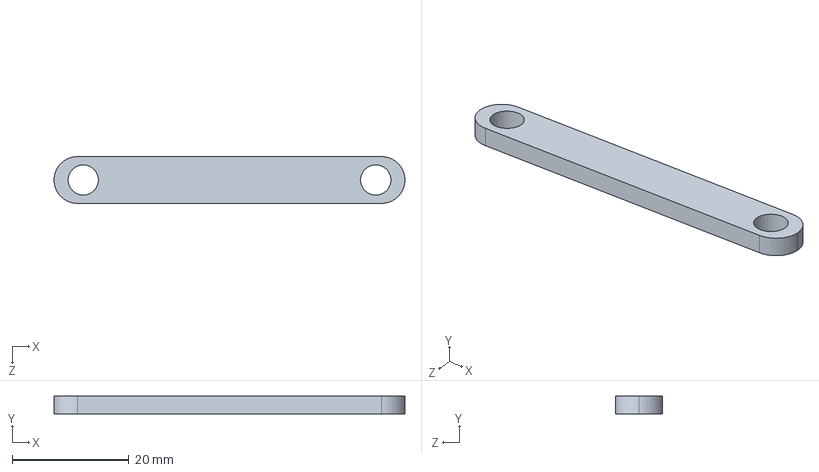
[picture p39: CAD file, 2026-11-14]
CAD_File/Main part/wheel dirctor - lock.SLDPRT
60.0 x 3.00 x 8.00 mm
