Eddym06/AutoNex/CAD_File/Electronic part/LIDAR.SLDASM

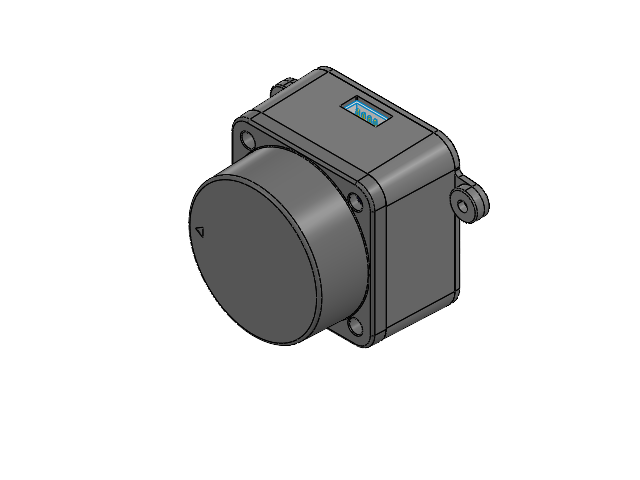
[picture p40: CAD file, 2026-11-14]
CAD_File/Electronic part/LIDAR.SLDASM
LD19_up.step
LD19_bottom.step
LD19_middle.step
LD19_PCB.step
PA2X6_1.step
PA2X6_2.step
PA2X6_3.step
PA2X6_4.step
