Eddym06/AutoNex/CAD_File/Electronic part/Esp32p4.SLDASM

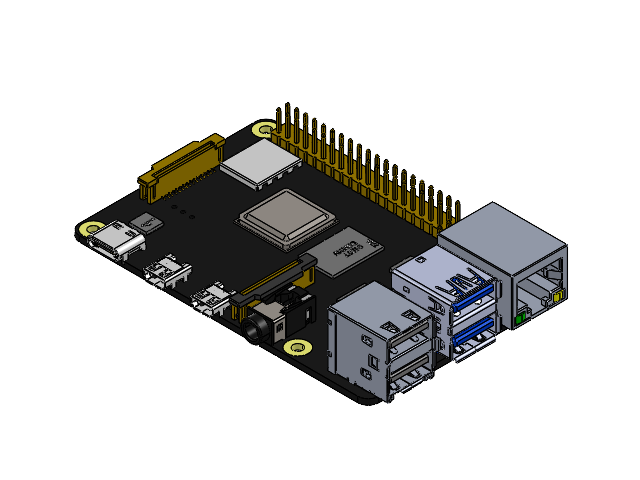
[picture p41: CAD file, 2026-11-14]
CAD_File/Electronic part/Esp32p4.SLDASM
PCB, RPi4ModelB.STEP
Broadcom BCM2711B0 CPU, RPi4ModelB.STEP
2.54 mm DUPONT MALE PIN HEADER, POE, 2X2, RPi4ModelB.STEP
2.54 mm DUPONT MALE PIN HEADER, IO, 2X20, RPi4ModelB.STEP
Camera Connector, RPi4ModelB.STEP
Microphone Plug, RPi4ModelB.STEP
Display Connector, RPi4ModelB.STEP
Gigabit Ethernet Port, RPi4ModelB.STEP
Female Micro HDMI Connector, RPi4ModelB.STEP x 2
Female USB Type C Connector, RPi4ModelB.STEP
2X USB3.0 PORTS, RPi4ModelB.STEP
91D77 D9WHV 778K, 4 GB LPDDR4 SDRAM, RPi4ModelB.STEP
Cypress CYW43455 Wireless Module Cover, RPi4ModelB.STEP
SD Card Slot, RPi4ModelB.STEP
VIA VL805 PCIe USB 3.0 controller, RPi4ModelB.STEP
2X USB2.0 PORTS, RPi4ModelB.STEP
Broadcom BCM54213PE Gigabit Ethernet Transceiver, RPi4ModelB.STEP
MxL7704 Universal PMIC, RPi4ModelB.STEP
