Eddym06/AutoNex/CAD_File/Main part/Feetech SCS0009 v9.SLDASM

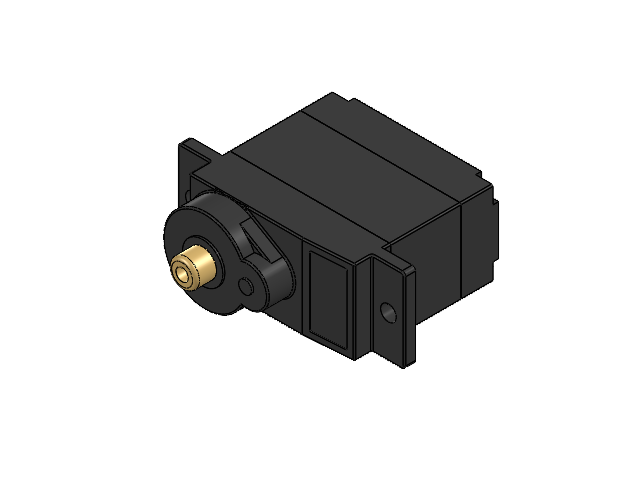
[picture p42: CAD file, 2026-11-14]
CAD_File/Main part/Feetech SCS0009 v9.SLDASM
91772A071_NO THREADS_Passivated 18-8 Stainless Steel Pan Head Phillips Screw.step x 4
eBom-FreeParts.step
