Eddym06/AutoNex/(list of files, cad)

Other CAD files:
CAD_File/Diferencial/gear1.SLDPRT
CAD_File/Main part/wheel screws.SLDPRT
Motor Control/design 3d/DiscoEncoder_30ranuras.f3d
Motor Control/design 3d/DiscoEncoder_30ranuras.stl
