Eddym06/AutoNex/LIDAR System/main/park_planner.c

#include "park_planner.h"

#include <math.h>
#include <string.h>

/* Las rejillas de busqueda ocupan ~900 KB: en el ESP32 van a la PSRAM. */
#ifdef ESP_PLATFORM
#include "esp_attr.h"
#define PARK_BIG_BSS EXT_RAM_BSS_ATTR
#else
#define PARK_BIG_BSS
#endif

#define NU PARK_NU
#define NW PARK_NW
#define DEG2RAD 0.017453292519943295f
#define INF16 0xFFFFu
#define F_FREE 0x01u
#define F_ROTP 0x02u   /* se puede girar de este rumbo al siguiente (k+1) sin chocar */
#define F_NEAR 0x04u   /* libre, pero con menos de soft_margin de holgura */
#define NEAR_PENALTY 10
#define MAX_COMP 3     /* vectores primitivos con componentes <= 3: 32 rumbos */

static park_params_t g_p;
static park_goal_t g_goal;
static bool g_ready;
static int g_last_i = -1, g_last_j = -1, g_last_k = -1;   /* ultima celda decidida (ver to_state) */

static int g_nk;
static int g_dx[PARK_MAX_HEADINGS], g_dy[PARK_MAX_HEADINGS];
static float g_deg[PARK_MAX_HEADINGS];
static int g_cost_fwd[PARK_MAX_HEADINGS], g_cost_back[PARK_MAX_HEADINGS], g_cost_rot[PARK_MAX_HEADINGS];

static PARK_BIG_BSS uint16_t g_cost[PARK_MAX_HEADINGS][NW][NU];
static PARK_BIG_BSS uint8_t g_flags[PARK_MAX_HEADINGS][NW][NU];
static PARK_BIG_BSS uint32_t g_queue[PARK_MAX_HEADINGS * NW * NU];

static float lot_len(const park_params_t *p)
{
    return p->lot_length_cm > 0.0f ? p->lot_length_cm : 1.5f * p->robot_length_cm;
}

void park_params_default(park_params_t *p, float width, float length, float rear)
{
    if (!p) return;
    memset(p, 0, sizeof(*p));
    p->robot_width_cm = width;
    p->robot_length_cm = length;
    p->rear_overhang_cm = rear;
    p->lot_length_cm = 0.0f;
    p->lot_width_cm = 20.0f;
    p->limiter_thickness_cm = 2.0f;
    p->margin_cm = 1.5f;
    p->soft_margin_cm = 3.5f;
    p->goal_theta_tol_deg = 6.0f;
    p->goal_slack_cm = 1.5f;
    p->exit_clear_cm = 1.0f;
}

/* ---------------------------------------------------------------- geometria */

void park_body_corners(const park_params_t *p, const park_pose_t *pose, float out[4][2])
{
    const float th = pose->theta_deg * DEG2RAD, c = cosf(th), s = sinf(th);
    const float fs[4][2] = {{-p->rear_overhang_cm, -p->robot_width_cm * 0.5f},
                            {p->robot_length_cm - p->rear_overhang_cm, -p->robot_width_cm * 0.5f},
                            {p->robot_length_cm - p->rear_overhang_cm, p->robot_width_cm * 0.5f},
                            {-p->rear_overhang_cm, p->robot_width_cm * 0.5f}};
    for (int n = 0; n < 4; ++n) {
        out[n][0] = pose->u_cm + fs[n][0] * c - fs[n][1] * s;
        out[n][1] = pose->w_cm + fs[n][0] * s + fs[n][1] * c;
    }
}

/* Cuerpo convexo (4 puntos) contra rectangulo alineado, con holgura (SAT). */
static bool hits_rect(float poly[4][2], float x0, float x1, float y0, float y1, float margin)
{
    x0 -= margin; x1 += margin; y0 -= margin; y1 += margin;
    float minx = 1e9f, maxx = -1e9f, miny = 1e9f, maxy = -1e9f;
    for (int n = 0; n < 4; ++n) {
        if (poly[n][0] < minx) minx = poly[n][0];
        if (poly[n][0] > maxx) maxx = poly[n][0];
        if (poly[n][1] < miny) miny = poly[n][1];
        if (poly[n][1] > maxy) maxy = poly[n][1];
    }
    if (maxx < x0 || minx > x1 || maxy < y0 || miny > y1) return false;
    const float bx[2] = {x0, x1}, by[2] = {y0, y1};
    for (int e = 0; e < 2; ++e) {
        float nx = -(poly[e + 1][1] - poly[e][1]), ny = poly[e + 1][0] - poly[e][0];
        const float len = hypotf(nx, ny);
        nx /= len; ny /= len;
        float pmin = 1e9f, pmax = -1e9f, rmin = 1e9f, rmax = -1e9f;
        for (int q = 0; q < 4; ++q) {
            const float d = poly[q][0] * nx + poly[q][1] * ny;
            if (d < pmin) pmin = d;
            if (d > pmax) pmax = d;
        }
        for (int a = 0; a < 2; ++a) for (int b = 0; b < 2; ++b) {
            const float d = bx[a] * nx + by[b] * ny;
            if (d < rmin) rmin = d;
            if (d > rmax) rmax = d;
        }
        if (pmax < rmin || pmin > rmax) return false;
    }
    return true;
}

static bool pose_collides(const park_params_t *p, float u, float w, float theta_deg)
{
    const park_pose_t pose = {u, w, theta_deg};
    float c[4][2];
    park_body_corners(p, &pose, c);
    const float half = lot_len(p) * 0.5f, t = p->limiter_thickness_cm;
    return hits_rect(c, -400.0f, 400.0f, -100.0f, 0.0f, p->margin_cm) ||            /* pared */
           hits_rect(c, -half - t, -half, 0.0f, p->lot_width_cm, p->margin_cm) ||   /* tope trasero */
           hits_rect(c, half, half + t, 0.0f, p->lot_width_cm, p->margin_cm);       /* tope delantero */
}

bool park_pose_free(const park_params_t *p, const park_pose_t *pose)
{
    return p && pose && !pose_collides(p, pose->u_cm, pose->w_cm, pose->theta_deg);
}

static float rect_boundary_distance(float u, float w, float x0, float x1, float y0, float y1)
{
    const float dx = fmaxf(fmaxf(x0 - u, 0.0f), u - x1), dy = fmaxf(fmaxf(y0 - w, 0.0f), w - y1);
    if (dx > 0.0f || dy > 0.0f) return hypotf(dx, dy);
    return fminf(fminf(u - x0, x1 - u), fminf(w - y0, y1 - w));   /* dentro: a la arista mas cercana */
}

float park_model_distance(const park_params_t *p, float u, float w)
{
    const float half = lot_len(p) * 0.5f, t = p->limiter_thickness_cm;
    float d = fabsf(w);
    const float d1 = rect_boundary_distance(u, w, -half - t, -half, 0.0f, p->lot_width_cm);
    const float d2 = rect_boundary_distance(u, w, half, half + t, 0.0f, p->lot_width_cm);
    if (d1 < d) d = d1;
    if (d2 < d) d = d2;
    return d;
}

/* ------------------------------------------------------------------ rumbos */

static void build_headings(void)
{
    int dx[PARK_MAX_HEADINGS], dy[PARK_MAX_HEADINGS];
    float ang[PARK_MAX_HEADINGS];
    int n = 0;
    for (int x = -MAX_COMP; x <= MAX_COMP; ++x) {
        for (int y = -MAX_COMP; y <= MAX_COMP; ++y) {
            if (x == 0 && y == 0) continue;
            int a = x < 0 ? -x : x, b = y < 0 ? -y : y;
            while (b) { const int t = a % b; a = b; b = t; }
            if (a != 1) continue;                      /* solo vectores primitivos */
            if (n < PARK_MAX_HEADINGS) { dx[n] = x; dy[n] = y; ang[n] = atan2f((float)y, (float)x) / DEG2RAD; ++n; }
        }
    }
    /* Ordenados por angulo, de -180 a 180; el rumbo 0 queda en su sitio. */
    for (int i = 1; i < n; ++i) {
        const int xi = dx[i], yi = dy[i];
        const float ai = ang[i];
        int j = i - 1;
        while (j >= 0 && ang[j] > ai) { dx[j + 1] = dx[j]; dy[j + 1] = dy[j]; ang[j + 1] = ang[j]; --j; }
        dx[j + 1] = xi; dy[j + 1] = yi; ang[j + 1] = ai;
    }
    g_nk = n;
    for (int k = 0; k < n; ++k) {
        g_dx[k] = dx[k]; g_dy[k] = dy[k]; g_deg[k] = ang[k];
        const float len = hypotf((float)dx[k], (float)dy[k]) * PARK_CELL_CM;
        g_cost_fwd[k] = (int)lroundf(4.0f * len);
        g_cost_back[k] = (int)lroundf(4.6f * len);
        float d = ang[(k + 1) % n] - ang[k];
        if (d < 0.0f) d += 360.0f;
        g_cost_rot[k] = 4 + (int)lroundf(d / 4.0f);       /* de k a k+1 */
    }
}

static int nearest_heading(float theta_deg)
{
    int best = 0;
    float best_d = 1e9f;
    for (int k = 0; k < g_nk; ++k) {
        float d = fabsf(theta_deg - g_deg[k]);
        while (d > 360.0f) d -= 360.0f;
        if (d > 180.0f) d = 360.0f - d;
        if (d < best_d) { best_d = d; best = k; }
    }
    return best;
}

size_t park_heading_count(void) { return (size_t)g_nk; }
float park_heading_deg(size_t k) { return k < (size_t)g_nk ? g_deg[k] : 0.0f; }
void park_heading_step(size_t k, float *du_cm, float *dw_cm)
{
    if (k >= (size_t)g_nk) { *du_cm = 0.0f; *dw_cm = 0.0f; return; }
    *du_cm = (float)g_dx[k] * PARK_CELL_CM;
    *dw_cm = (float)g_dy[k] * PARK_CELL_CM;
}
size_t park_heading_nearest(float theta_deg) { return (size_t)nearest_heading(theta_deg); }

/* ------------------------------------------------------------------- campo */

static inline size_t sidx(int k, int j, int i) { return ((size_t)k * NW + (size_t)j) * NU + (size_t)i; }
static inline float cell_u(int i) { return PARK_U0_CM + ((float)i + 0.5f) * PARK_CELL_CM; }
static inline float cell_w(int j) { return ((float)j + 0.5f) * PARK_CELL_CM; }

static bool body_inside_lot(const park_params_t *p, float u, float w, float th)
{
    const park_pose_t pose = {u, w, th};
    float c[4][2];
    park_body_corners(p, &pose, c);
    const float half = lot_len(p) * 0.5f - p->goal_slack_cm;
    for (int n = 0; n < 4; ++n)
        if (c[n][0] < -half || c[n][0] > half || c[n][1] < p->goal_slack_cm ||
            c[n][1] > p->lot_width_cm - p->goal_slack_cm) return false;
    return true;
}

static bool body_clear_of_lot(const park_params_t *p, float u, float w, float th)
{
    const park_pose_t pose = {u, w, th};
    float c[4][2];
    park_body_corners(p, &pose, c);
    for (int n = 0; n < 4; ++n)
        if (c[n][1] < p->lot_width_cm + p->exit_clear_cm) return false;
    return true;
}
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
