Eddym06/AutoNex/LIDAR System/main/arena_localizer.c

#include "arena_localizer.h"

#include <math.h>
#include <string.h>

#define DEG2RAD 0.017453292519943295f
#define RAD2DEG 57.29577951308232f
#define MAX_PTS 400

typedef struct {
    bool vertical;           /* true: la pared es x = pos (normal en x); false: z = pos */
    float pos;
    float lo, hi;            /* extension a lo largo de la pared */
} wall_t;

static float wrap_deg(float a)
{
    while (a > 180.0f) a -= 360.0f;
    while (a <= -180.0f) a += 360.0f;
    return a;
}

void arena_config_default(arena_config_t *c)
{
    c->outer_half_cm = 150.0f;
    c->inner_half_cm = 50.0f;
    c->tol_cm = 6.0f;
    c->gain = 0.6f;
    c->min_support = 12;
    c->max_shift_cm = 30.0f;
    c->max_rot_deg = 8.0f;
    c->min_range_cm = 8.0f;
    c->max_range_cm = 300.0f;
    c->init_min_score = 0.45f;
}

static bool clampf_(float *v, float lo, float hi)
{
    if (!(*v >= lo)) { *v = lo; return true; }
    if (*v > hi) { *v = hi; return true; }
    return false;
}

bool arena_config_sanitize(arena_config_t *c)
{
    bool ch = false;
    ch |= clampf_(&c->outer_half_cm, 60.0f, 1000.0f);
    ch |= clampf_(&c->inner_half_cm, 10.0f, c->outer_half_cm - 30.0f);
    ch |= clampf_(&c->tol_cm, 1.0f, 20.0f);
    ch |= clampf_(&c->gain, 0.05f, 1.0f);
    if (c->min_support < 3) { c->min_support = 3; ch = true; }
    ch |= clampf_(&c->max_shift_cm, 2.0f, 100.0f);
    ch |= clampf_(&c->max_rot_deg, 1.0f, 30.0f);
    ch |= clampf_(&c->min_range_cm, 0.0f, 50.0f);
    ch |= clampf_(&c->max_range_cm, 50.0f, 1000.0f);
    ch |= clampf_(&c->init_min_score, 0.1f, 0.95f);
    return ch;
}

void arena_init(arena_loc_t *a, const arena_config_t *cfg)
{
    memset(a, 0, sizeof(*a));
    if (cfg) a->cfg = *cfg; else arena_config_default(&a->cfg);
    arena_config_sanitize(&a->cfg);
}
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
