Eddym06/AutoNex/(commit log)

2026-11-07 chore: organizar estructura inicial del proyecto
    Crear las carpetas para control, percepción, comunicaciones, simulación y componentes mecánicos del vehículo.
2026-11-07 feat: incorporar software del vehículo autónomo
    Agregar firmware de navegación y visión, protocolos, simulador y herramientas. Preparar la tracción trasera con dirección Ackermann y encoder en cuadratura, con parámetros de hardware configurables y documentación de integración.
    Mantener la tracción bloqueada por defecto y documentar las calibraciones y la adaptación del estacionamiento pendientes.
    [DiscoEncoder_30ranuras.f3d, DiscoEncoder_30ranuras.step, DiscoEncoder_30ranuras.stl, partitions.csv]
2026-11-08 feat: adaptar simulador y control al chasis Ackermann
    Incorpora encoder de eje, planificador de parqueo y orquestador; corrige avisos de pista, valida la interfaz WASM y añade pruebas focalizadas y CI. Documenta los límites de simulación y la calibración pendiente.
    [axle_encoder.h, core_api.c, hw_encoders.c, local_obstacle_map.h, manifest.py, p4_runtime.c, p4_runtime.h]
2026-11-08 feat(simulador): cajon a medida del chasis, parqueo Ackermann a 40 grados y tiempos
    Simulador y control del parqueo. Todo verificado con simulate.ps1 -Quick (verde),
    test_missions.js (21/21) y comprobacion en Chrome.
    Pista y chasis:
    - field.fitToRobot: el cajon (1,5 x el robot) y la pose de arranque (cuerpo centrado)
    se ajustan al chasis simulado. Un plano puede declarar su chasis (
    obot en el
    JSON, robot.js:PROFILES) y todos los que lo reproducen usan ese perfil.
    - Nuevo perfil medido largo26 (260 x 130 mm, batalla 184,5, rueda 66): salida en
    8,1-8,6 s y mision de 62 puntos en 4 de 4.
    - El controlador recibe el largo real del cajon (park_lot_length_cm) en vez de suponer
    1,5 x su pr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
2026-11-08 fix(parqueo): primitiva de entrada en una S, penalizacion de cambio de sentido a 12
    Intento de bajar las repasadas de la entrada al cajon (8) a una sola.
    Medido: la entrada necesita 7-8; con la primitiva S implementada no baja porque
    la geometria no da (ver ESTADO.md).
    - park_ackermann_entry_s: entrada como la hace una persona (reversa larga +
    avance de enderezado) buscando las dos longitudes con la geometria real y
    comprobando que quede centrada y paralela. Se intenta una vez al llegar al
    carril y, si no hay solucion, manda el A* como siempre. Con cajon de 20 de
    fondo no encuentra solucion: retroceder con el volante al maximo desde el
    carril engancha la esquina trasera con el top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
    [core_api.c, park_ackermann.c, park_ackermann.h, wro_controller.c]
2026-11-08 feat(parqueo): maniobra de entrada de tres tramos (2 cambios de sentido)
    La entrada al cajon se planeaba con el A* de arcos de 3,5 cm, que castiga el rumbo
    grande en su heuristica y solo sabia entrar casi paralelo a mordiscos: 10 pasadas
    (8 tras subir la penalizacion de cambio de sentido).
    - park_ackermann_entry_maneuver: busca tres tramos con el volante al maximo
    (colocarse con un arco de avance, entrar girando con un arco largo de reversa,
    enderezar) comprobando la geometria real y exigiendo que termine centrada y
    paralela. El plan sale con 2 cambios de sentido (AAAA...RRRR...A).
    - Se intenta en cada repaso mientras el coche siga en el carril; desde dentro del
    cajon manda el A* (i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
    [park_ackermann.c, park_ackermann.h, wro_controller.c]
2026-11-09 medida de la entrada al cajon: herramienta, prueba y diagnostico
    La entrada al cajon se movia entre 3 y 8 repasadas sin que ninguna prueba lo
    notara (la salida si esta medida: 8-9 s y 1 repasada). Se añade:
    - simulator/tests/parkentry.js: cuenta las repasadas de la entrada y de la
    salida con la pose verdadera, por fase y con traza por barrido.
    - simulator/tests/test_parking_entry.js: las acota (<= 4) en la maniobra de
    demostracion y exige aparcado completo y sin contactos. Engancha en
    simulate.ps1.
    - core.js: parkPlan(), que hasta ahora no dejaba ver el plan de la maniobra
    (nodos expandidos, paso, arcos que quedan).
    - README y ESTADO: la simetria salida->entrada es correcta en el p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
2026-11-09 parqueo: la entrada arranca donde acaba la salida y los arcos se metran por giroscopio
    PARK_EXIT recuerda la pose donde termino. La entrada, en vez de empezar donde el
    LiDAR ve el cajon por primera vez (4-8 repasadas, el A* gasta el carril entero),
    cruza el carril a 12 cm/s hasta 2 cm mas adelante y 1,5 mas lejos de la pared -
    donde el planificador aislado baja de 2 a 1 repasada - y desde ahi hace UN solo
    plan.
    El plan se abortaba a ~10 grados de morro y la correccion costaba otra repasada:
    el servo tarda 0,2 s en invertir el volante y los arcos medidos por distancia se
    cortan 0,2-0,3 cm pronto. Para la entrada simetrica los arcos se cortan por rumbo
    del giroscopio, se vigila el avance a ci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
2026-11-09 medida de la entrada: filtrar por sentido y semilla, y lo que queda anotado
    parkentry.js acepta DIR y SEED para medir un solo caso (la traza de una ronda
    tarda ~25 s y hacia falta mirar casos sueltos).
    ESTADO.md anota el resultado de las tres vias probadas para que la entrada sea
    siempre 3 repasadas, las tres cerradas con medida:
    - la cuenta del A* no es un parametro: desde poses a 1 cm da 1 o 2, y subir el
    castigo por cambio de sentido a 60 cm la deja en 2-10 segun el caso;
    - la S de dos arcos calculada no cabe: la esquina pasa 0,9 cm por encima del
    tope delantero con la holgura de planeo, y por detras engancha el trasero;
    - la maniobra de tres tramos no se acepta nunca (patron de vola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
2026-11-09 parqueo: el servo se pone antes de mover, y analisis completo del flujo
    La entrada simetrica planea con un modelo que supone el volante ya puesto, pero
    el servo tarda ~0,2 s en pasar de un tope al otro: el primer arco de cada cambio
    giraba menos de lo planeado, el desvio se acumulaba (3 cm y 10 grados en 15
    arcos) y el controlador abortaba el plan; la correccion costaba una repasada
    mas. Ahora, antes de mover, se le da el volante al servo con el coche quieto: 1
    barrido si el cambio es pequeno, 2 si invierte de tope a tope. Solo en la entrada
    simetrica (la demostracion desde la pista y el tanteo se quedan igual, que
    cambiarlos deja el parqueo en parcial).
    Ronda completa (largo26, 4 semillas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
2026-11-10 MIC (Motor Intelligent Control): control central del motor JGB37-520 e integracion en el firmware del P4
    Modulo C99 con modelo fisico del motor, observador de tres ordenes, planificador con
    anticipacion y frenado progresivo o agresivo. En hw_motors.c corre a 1 kHz tras
    CONFIG_WRO_USE_MIC (apagado por defecto); hw_encoders expone las cuentas. Probado solo
    contra un motor simulado; incluye procedimiento de calibracion.
2026-11-10 trace_map v2: espacio libre, objetos con color y posicion, plaza de parqueo y guardado
    Rejilla con rayos que atraviesan (libre/desconocido/borrado de lo que se mueve), objetos
    con id estable, pilares y barras, plaza detectada por geometria del par de topes,
    consultas y guardado con CRC. Medido en simulador contra la verdad; no probado con LiDAR real.
2026-11-10 Parqueo y simulador: meta de entrada, coste de holgura, MIC y avances exactos en el simulador, mediciones
    A* con coste suave de holgura y meta de entrada con rumbo <= 4 grados; el chequeo de arco ya no es mas
    estricto que el plan. Experimentos apagados por flag (retorno por traza, gemelo, avances exactos).
    El simulador admite un motor fisico gobernado por MIC. Mediciones, herramientas y PENDIENTES_PARQUEO.md.
2026-11-10 Documentacion: estado del 10 nov, arquitectura (parqueo, MIC, trace_map), simulador y mapa de documentos
2026-11-10 trace_map oficial: vueltas (construye en la 1.a, refina despues), guardado en particion de flash del P4 y dibujo en el simulador
    [partitions.csv]
2026-11-10 Medicion de trace_map en la vuelta 1 y 3 y comparacion de la plaza del mapa con la localizacion del parqueo
2026-11-10 trace_map: promedio de las pasadas (hits de 8 bits y superficie), mediciones en paralelo con log y diagnostico del error sistematico de la pose
    [core_api.c, test_trace_map.c, trace_map.c, trace_map.h]
2026-11-10 arena_localizer: medicion del error y barrido de parametros (sin cambiar defectos), ganancia/tolerancia/alcance configurables y correccion del diagnostico de la latencia
    [wro_controller.c]
2026-11-10 Trayectoria inteligente (IT): planificador por optimizacion con huella del chasis, seguidor, agarre aprendido; simulador con servo MG90S, neumaticos y peso trasero (largo26d); banco y medidas
2026-11-10 IT integrada en la mision: plan por rebanadas desde trace_map, lazo rapido con encoders y giroscopio, cesion al reactivo y al parqueo, MIC, web; odometria sin tope de 150 cm/s; holgura de la huella e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
2026-11-10 README profesional (EN/ES) con animacion, graficos y capturas reales; documentos de diseno y electronica; velocidad de mapeo 35 cm/s
2026-11-11 Motor de 600 rpm en todo el repo (MIC, Kconfig, simulador, docs); velocidad de mapeo 34; tope de aproximacion al parqueo; build y pruebas corregidos (it_plan.c); documentos de estado actualizados
2026-11-11 Entrada al cajon: eleccion entre 5 planes candidatos (rescata poses sin plan), diagnostico de abortos por arco/desvio, margen de comprobacion configurable, prueba de robustez; rebuild_wasm.sh admite 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
2026-11-11 Parqueo: pose libre mas cercana si la medida solapa el cajon (evita el 'stalled'), movimiento de recuperacion sin plan; measure_mission usa pistas factibles; diagnostico ampliado; causa del wrong-sid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
    [core_api.c, wro_controller.c, wro_controller.h]
2026-11-11 Esquina: guarda de rumbo 45 grados (30 bloqueaba la esquina en cw tras un cambio de carril a pendiente alta); prueba de simetria con pista reflejada documentada
2026-11-11 Cierra los dos fallos de pistas factibles: referencia de rumbo acotada a 85 grados entre 90 y 135 (atasco en la esquina de la vuelta 3), comprobacion de arco de la entrada a 0,75 cm (contacto con el 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
2026-11-11 Simulador: IT, cajon y arranque en el cajon activos por defecto; sorteo repone letreros; pose estimada dibujada sin retraso; parqueo para al cumplir la meta; juez espera 3 s; IT hasta la ultima esqui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
2026-11-12 electronica actualizada con la placa de comunicacion del servo por ST/SC
2026-11-13 docs(design): documento de diseno mecanico v2 completo
    Reemplaza el esqueleto por el diseno mecanico completo: numeros clave con su fuente ([measured]/[CAD]/[calculated]/[pending]), chasis y tren motriz, geometria Ackermann, distribucion de peso, montaje de sensores, BOM con los nombres reales del CAD, decisiones, riesgos y plan de pruebas.
    Incluye las discrepancias abiertas: batalla 163 mm vs 184.5 mm del firmware, rueda 65/69/66 mm, servo MG90S vs SCS0009, LiDAR LD19 vs D500/D6, rodamientos delanteros en CAD vs traseros, y el placeholder de Esp32p4.
2026-11-14 CAD subido piezas y ensamble
    [Assembly dc motor.SLDASM, Axis of dc motor.SLDPRT, Axis of gear 2.SLDPRT, Axis of wheel.SLDPRT, Base of gear.SLDPRT, Base.SLDPRT, Batery.SLDPRT, Bsae of lidar.SLDPRT]
2026-11-14 bitacora hecho hasta el 13 de nov 2026
2026-11-14 se quito una oracion en la bitacora
2026-11-14 nombres completos en el readme
2026-11-14 actualizacion del driver a DRV8871
